8-BitLab/safestep/hardware/Week 4/Documents/SAFESTEP DESIGN DECISION_Week 4.pdf

### SAFESTEP DESIGN DECISION

### 1. Power

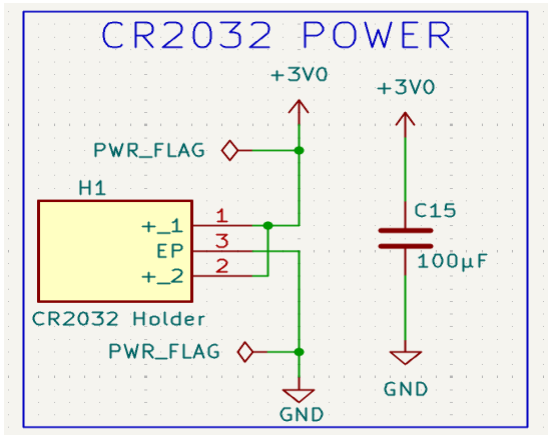
[picture p1: figure]

The device will be powered by CR2032 Battery. A CR2032 holder was added in the schematics.

CR2032 Battery: Nominal 3.0V (2.0v – 3.2v operating range), nominal capacity 220 -240mAh.

Battery Connection Flowchart
- CR2032 +
│
- 100μF (Bulk Decoupling Capacitor)

A 100 μF decoupling capacitor was added to act as a local energy tank that handles lowfrequency current spikes.

### 2. Reverse Protection

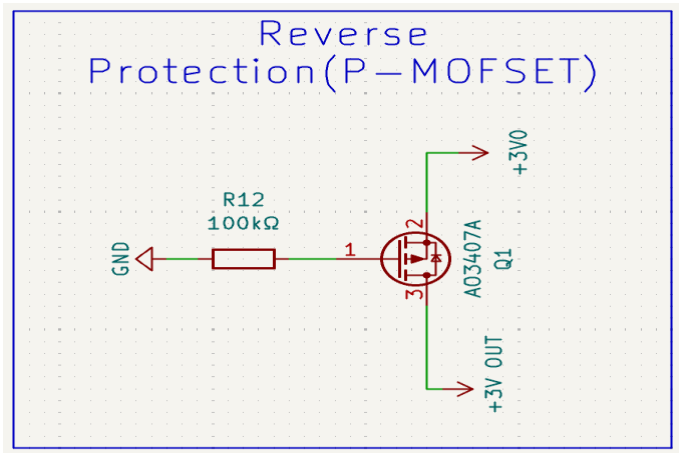
[picture p2: figure]

A P-MOFSET is used for reverse protection. The source is connected to the batteries positive terminal. The gate is pulled to ground via a 100k ohms resistor. The drain carried the output voltage.
The MOFSET of choice is AO3407A. The AO3407A uses advanced trench technology to provide excellent RDS (ON) with low gate charge. This device is suitable for use as a load switch or in PWM applications.
VDS | -30V
ID (at VGS=-10V) | -4.3A
RDS(ON) (at VGS=-10V) | < 48mW
RDS(ON) (at VGS =-4.5V) | < 78mW

3. ESP32 C3

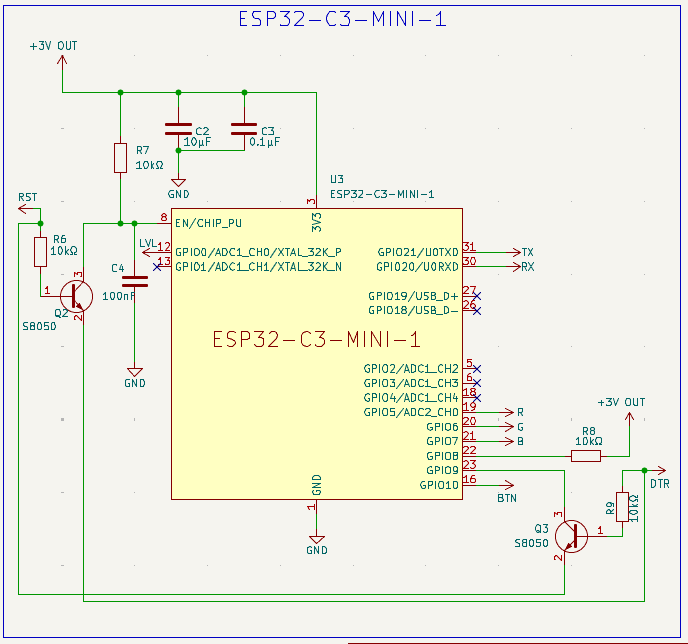
[picture p3: figure]

The ESP32-C3-MINI-1 is used as the MCU of choice for this project.

The power pin is supplied by the output from the MOSFET drain.

GPIO 8 is pulled high via a 10k ohms resistor to allow the MCU enter normal mode after reset.

Tx and Rx lines are connected to the UART pins.

The Enable pin is pulled high using a 10k ohms resistor and a 100nF capacitor pulled to the ground. An NPN transistor is connected to the same pin to allow for hard reset via UART pins.

The Boot pin is connected to an NPN transistor to allow for automatic state change via UART pins.

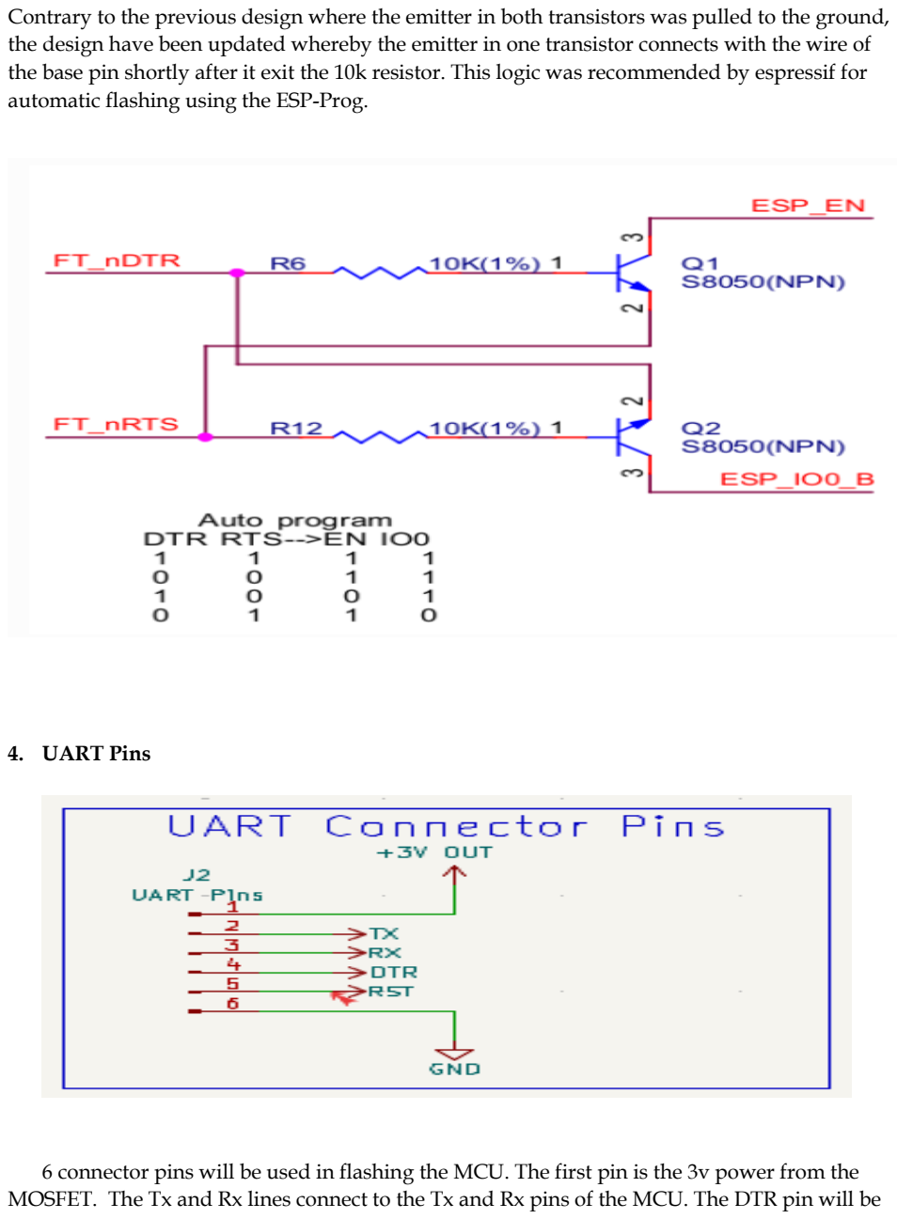
[picture p4: page 4]

Contrary to the previous design where the emitter in both transistors was pulled to the ground, the design have been updated whereby the emitter in one transistor connects with the wire of the base pin shortly after it exit the 10k resistor. This logic was recommended by espressif for automatic flashing using the ESP-Prog.

### 4. UART Pins

6 connector pins will be used in flashing the MCU. The first pin is the 3v power from the MOSFET. The Tx and Rx lines connect to the Tx and Rx pins of the MCU. The DTR pin will be used to automatically pull gpio9 Low, putting the MCU into download mode. The RST pin will automatically hard reset the MCU pin after flashing. The GND is connected to ground.

### 5. Battery Level

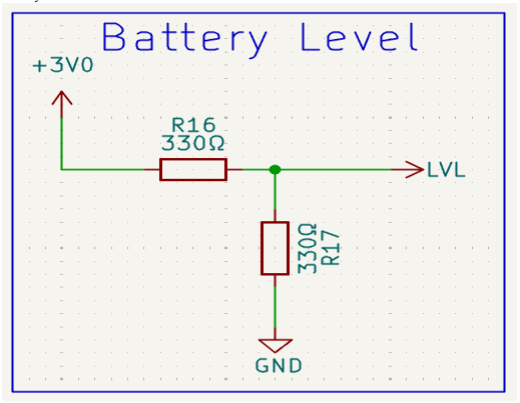
[picture p5: figure]

A battery capacity level monitoring was implemented using a voltage divider and ESP32 C3 ADC pin (gpio 0). This pin was tagged as LVL. The voltage divider serves to accurately divide the Input voltage (Battery 3v) and feed the voltage to the ADC where the voltage is converted to value. The Value can then be gotten through the firmware and multipled by 2 to get the correct voltage.
This logic was tested here and it turned out great: https://drive.google.com/file/d/1jga9iaDm6SIP6OQ40Vx7qFb9iOdV28Gf/view?usp=shar ing (https://drive.google.com/file/d/1jga9iaDm6SIP6OQ40Vx7qFb9iOdV28Gf/view?usp=sharing)

### 6. Button

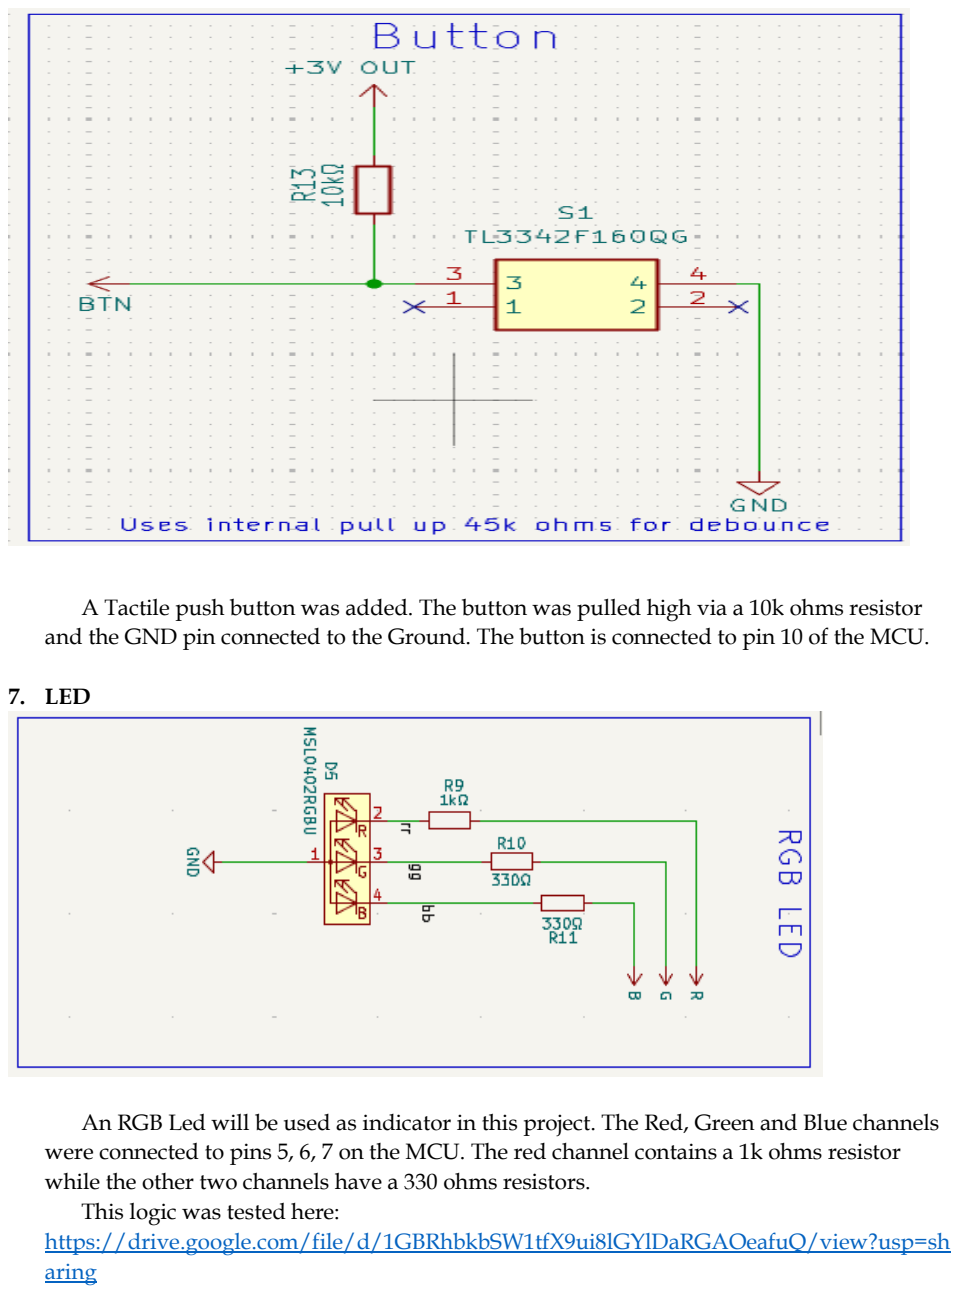
[picture p6: page 6]

A Tactile push button was added. The button was pulled high via a 10k ohms resistor and the GND pin connected to the Ground. The button is connected to pin 10 of the MCU.

### 7. LED

An RGB Led will be used as indicator in this project. The Red, Green and Blue channels were connected to pins 5, 6, 7 on the MCU. The red channel contains a 1k ohms resistor while the other two channels have a 330 ohms resistors.
This logic was tested here: https://drive.google.com/file/d/1GBRhbkbSW1tfX9ui8lGYlDaRGAOeafuQ/view?usp=sh aring (https://drive.google.com/file/d/1GBRhbkbSW1tfX9ui8lGYlDaRGAOeafuQ/view?usp=sharing)
