8-BitLab/safestep/hardware/Week 5/Documents/SAFESTEP DESIGN DECISION week 5.pdf

### SAFESTEP DESIGN DECISION

### 1. Power

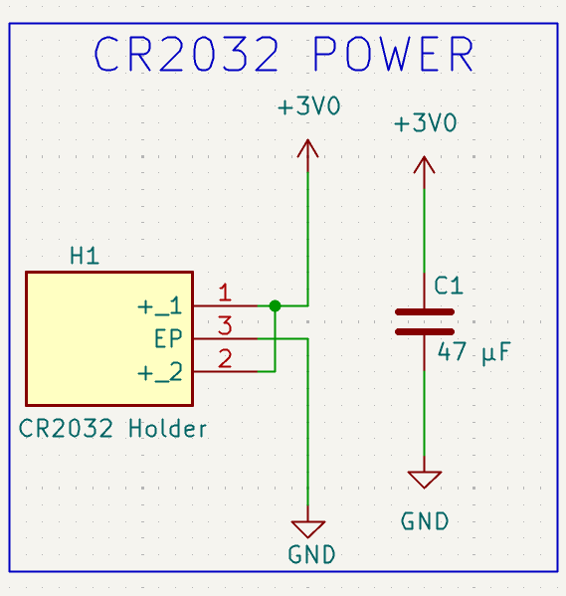
[picture p7: figure]

The device will be powered by CR2032 Battery. A CR2032 holder was added in the schematics.

CR2032 Battery: Nominal 3.0V (2.0v – 3.2v operating range), nominal capacity 220 -240mAh.

Battery Connection Flowchart
- CR2032 +

│
- 47μF (Bulk Decoupling Capacitor)

A 47 μF storage capacitor capacitor was added to act as a local energy tank that handles low-frequency current spikes.

### 2. Reverse Protection

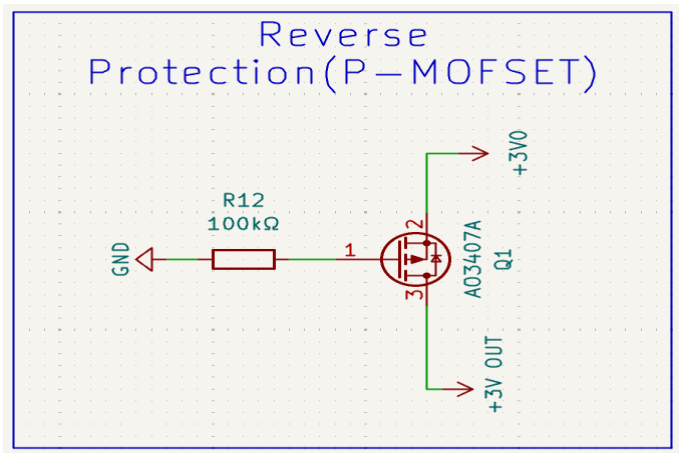
[picture p8: figure]

A P-MOFSET is used for reverse protection. The source is connected to the batteries positive terminal. The gate is pulled to ground via a 100k ohms resistor. The drain carried the output voltage.
The MOFSET of choice is AO3407A. The AO3407A uses advanced trench technology to provide excellent RDS (ON) with low gate charge. This device is suitable for use as a load switch or in PWM applications.
VDS | -30V
ID (at VGS=-10V) | -4.3A
RDS(ON) (at VGS=-10V) | < 48mW

RDS(ON) (at VGS =-4.5V) | < 78mW
3. ESP32 C3

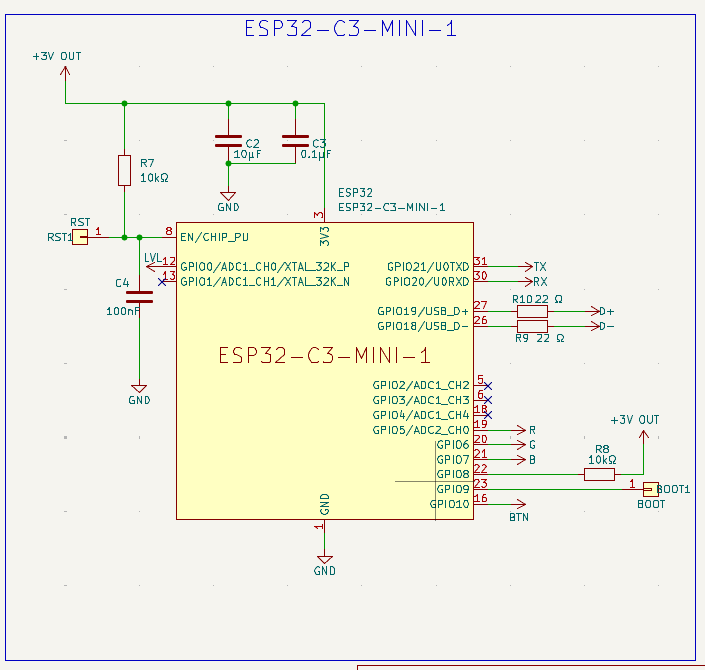
[picture p9: figure]

The ESP32-C3-MINI-1 is used as the MCU of choice for this project.

The power pin is supplied by the output from the MOSFET drain.

GPIO 8 is pulled high via a 10k ohms resistor to allow the MCU enter normal mode after reset.

Tx and Rx lines are connected to the UART pins.

The Enable pin is pulled high using a 10k ohms resistor and a 100nF capacitor pulled to the ground. A Test pad was added to CHIP_EN line to allow manual grounding (resetting) if the microcontroller locks up.

The Boot pin is connected to Test Pad If the USB controller becomes unresponsive due to a firmware crash or improper code, touch a ground wire to this pad to force the chip into download boot mode.

### 4. UART Pins

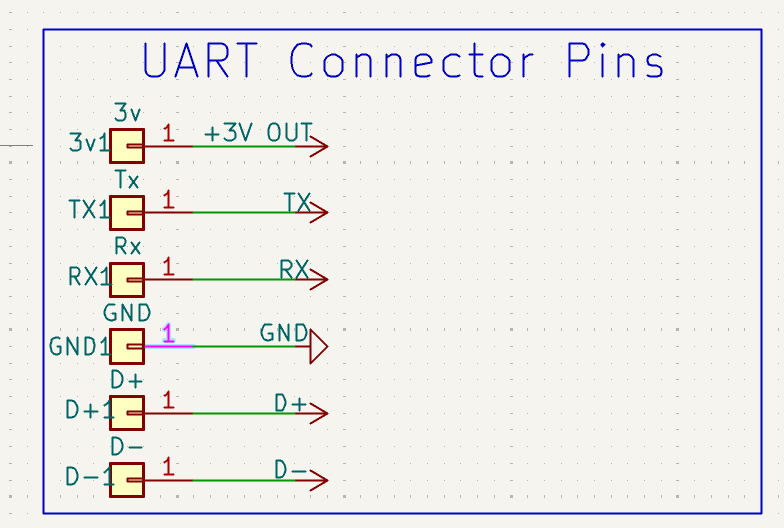
[picture p10: figure]

6 connector pins will be used in flashing the MCU. The first pin is the 3v power from the MOSFET. The Tx and Rx lines connect to the Tx and Rx pins of the MCU. The GND is connected to ground. The D+ and D- pins are for usb Data lines to be connected to the same pins in a USB C Breakout board.

### 5. Battery Level

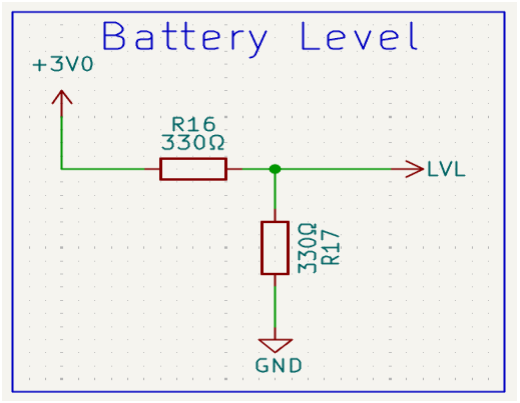
[picture p11: figure]

A battery capacity level monitoring was implemented using a voltage divider and ESP32 C3 ADC pin (gpio 0). This pin was tagged as LVL. The voltage divider serves to accurately divide the Input voltage (Battery 3v) and feed the voltage to the ADC where the voltage is converted to value. The Value can then be gotten through the firmware and multipled by 2 to get the correct voltage.
This logic was tested here and it turned out great: https://drive.google.com/file/d/1jga9iaDm6SIP6OQ40Vx7qFb9iOdV28Gf/view?usp=shar ing (https://drive.google.com/file/d/1jga9iaDm6SIP6OQ40Vx7qFb9iOdV28Gf/view?usp=sharing)

### 6. Button

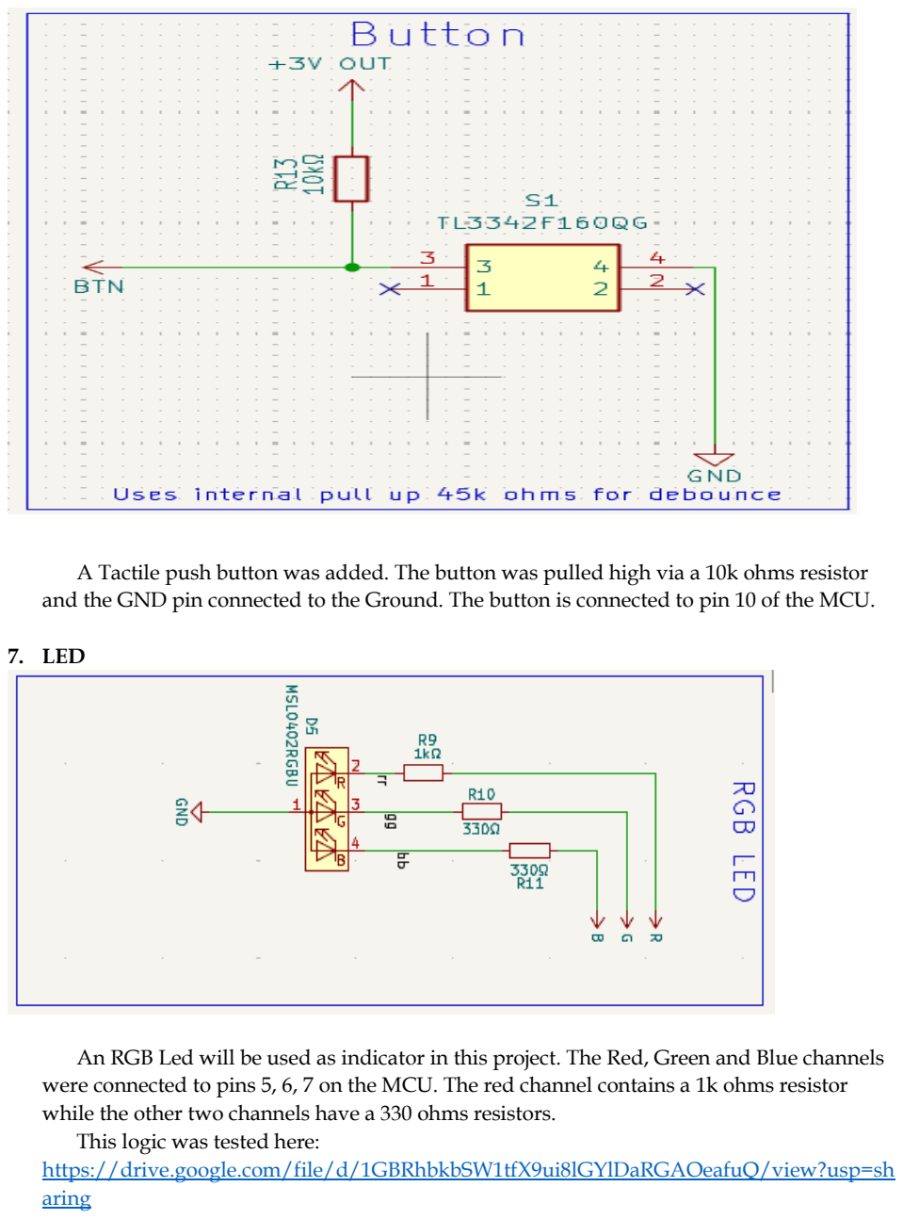
[picture p12: page 6]

A Tactile push button was added. The button was pulled high via a 10k ohms resistor and the GND pin connected to the Ground. The button is connected to pin 10 of the MCU.

### 7. LED

An RGB Led will be used as indicator in this project. The Red, Green and Blue channels were connected to pins 5, 6, 7 on the MCU. The red channel contains a 1k ohms resistor while the other two channels have a 330 ohms resistors.
This logic was tested here: https://drive.google.com/file/d/1GBRhbkbSW1tfX9ui8lGYlDaRGAOeafuQ/view?usp=sh aring (https://drive.google.com/file/d/1GBRhbkbSW1tfX9ui8lGYlDaRGAOeafuQ/view?usp=sharing)

TEST POINTS:

1. Boot: If the USB controller becomes unresponsive due to a firmware crash or improper code, you can manually touch a ground wire to this pad to force the chip into download boot mode.
2. Reset (RST) : connected to CHIP_EN line to allow manual grounding (resetting) if the microcontroller locks up.
