8-BitLab/safestep/hardware/Week 3/Documents/SAFESTEP DESIGN DECISION Week 3.pdf

### SAFESTEP DESIGN DECISION

### 1. Power


The device will be powered by CR2032 Battery. A CR2032 holder was added in the schematics.

CR2032 Battery: Nominal 3.0V (2.0v – 3.2v operating range), nominal capacity 220 -240mAh.

Battery Connection Flowchart
- CR2032 +
│
- 100μF (Bulk Decoupling Capacitor)

A 100 μF decoupling capacitor was added to act as a local energy tank that handles lowfrequency current spikes.

### 2. Reverse Protection


A P-MOFSET is used for reverse protection. The source is connected to the batteries positive terminal. The gate is pulled to ground via a 100k ohms resistor. The drain carried the output voltage.
The MOFSET of choice is AO3407A. The AO3407A uses advanced trench technology to provide excellent RDS(ON) with low gate charge. This device is suitable for use as a load switch or in PWM applications.
VDS | -30V
ID (at VGS=-10V) | -4.3A
RDS(ON) (at VGS=-10V) | < 48mW
RDS(ON) (at VGS =-4.5V) | < 78mW

3. ESP32 C3

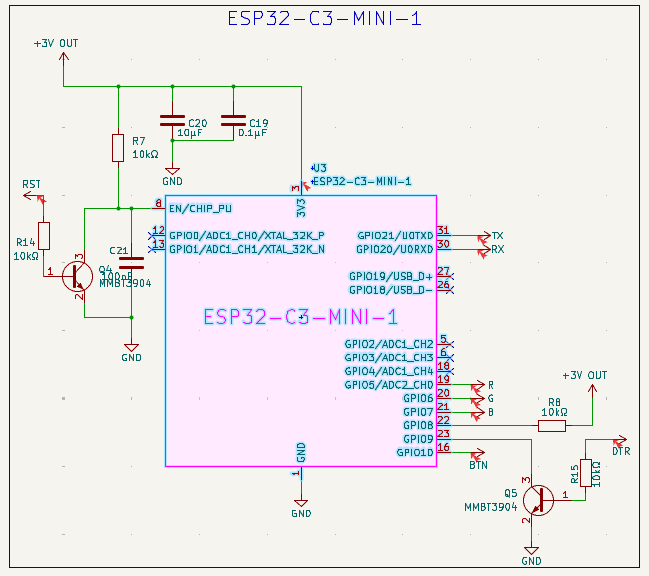
[picture p13: figure]

The ESP32-C3-MINI-1 is used as the MCU of choice for this project.

The power pin is supplied by the output from the MOSFET drain. T

he Enable pin is pulled high using a 10k ohms resistor and a 100nF capacitor pulled to the ground. An NPN transistor is connected to the same pin to allow for hard reset via UART pins.

The Boot pin is connected to an NPN transistor to allow for automatic state change via UART pins.

GPIO 8 is pulled high via a 10k ohms resistor to allow the MCU enter normal mode after reset.

Tx and Rx lines are connected to the UART pin

### 4. UART Pins

6 connector pins will be used in flashing the MCU. The first pin is the 3v power from the MOSFET. The Tx and Rx lines connect to the Tx and Rx pins of the MCU. The DTR pin will be used to automatically pull gpio9 Low, putting the MCU into download mode. The RST pin will automatically hard reset the MCU pin after flashing. The GND is connected to ground.

### 5. Button

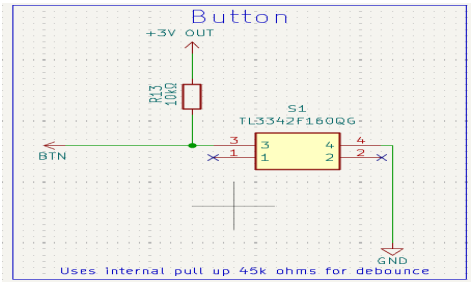
[picture p14: figure]

A Tactile push button was added. The button was pulled high via a 10k ohms resistor and the GND pin connected to the Ground. The button is connected to pin 10 of the MCU.

### 6. LED

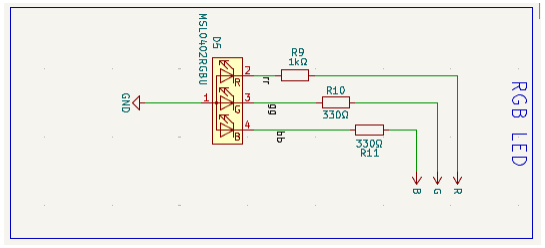
[picture p15: figure]

An RGB Led will be used as indicator in this project. The Red,Green and Blue channels were connected to pins 5, 6, 7 on the MCU . The red channel contains a 1k ohms resistor while the other two channels have a 330 ohms resistors.
