8-BitLab/safestep/hardware/Week 4/Research/COMPONENTS_v0.2.pdf

COMPONENTS

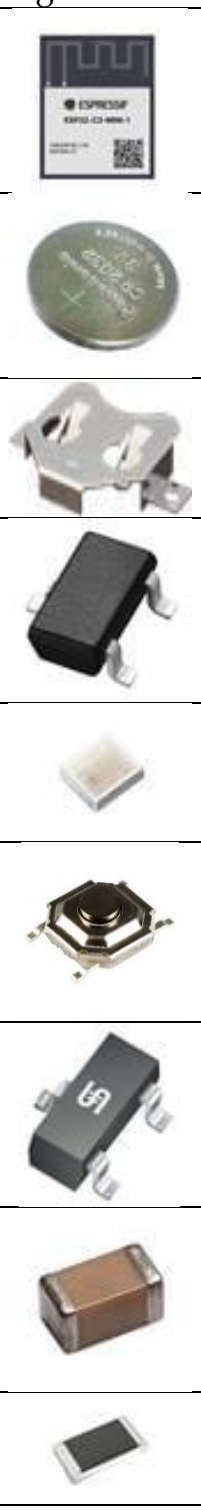
[picture p29: figure]

Image | Component | Type | Quantity | Price
| ESP32-C3-MINI-1 | MCU | 1 | 2.82 €
| CR2032 | Battery | 1 | 1.27 €
| BAT-HLD-003-SMT-TR | Battery Holder | 1 | 0.525 €
| AO3407A | P-MOSFET | 1 | 0.42 €
| MSL0402RGBU | RGB LED | 1 | 0.81 €
| TL3342F160QG/TR | BUTTON | 1 | 0.50 €
| S8050/SS8050 | NPN Transistor | 2 | 0.249 €
| 0402 Ceramic Capacitor | Capacitor | 10 | 2.27 €
| 0402 Thin Film Resistors | Resistors | 10 | 1.45 €
TOTAL | | | | 10.341 €
