8-BitLab/safestep/hardware/Week 7/Documents/Safestep esp32_c3_mini_1 Schematics v0.6.pdf

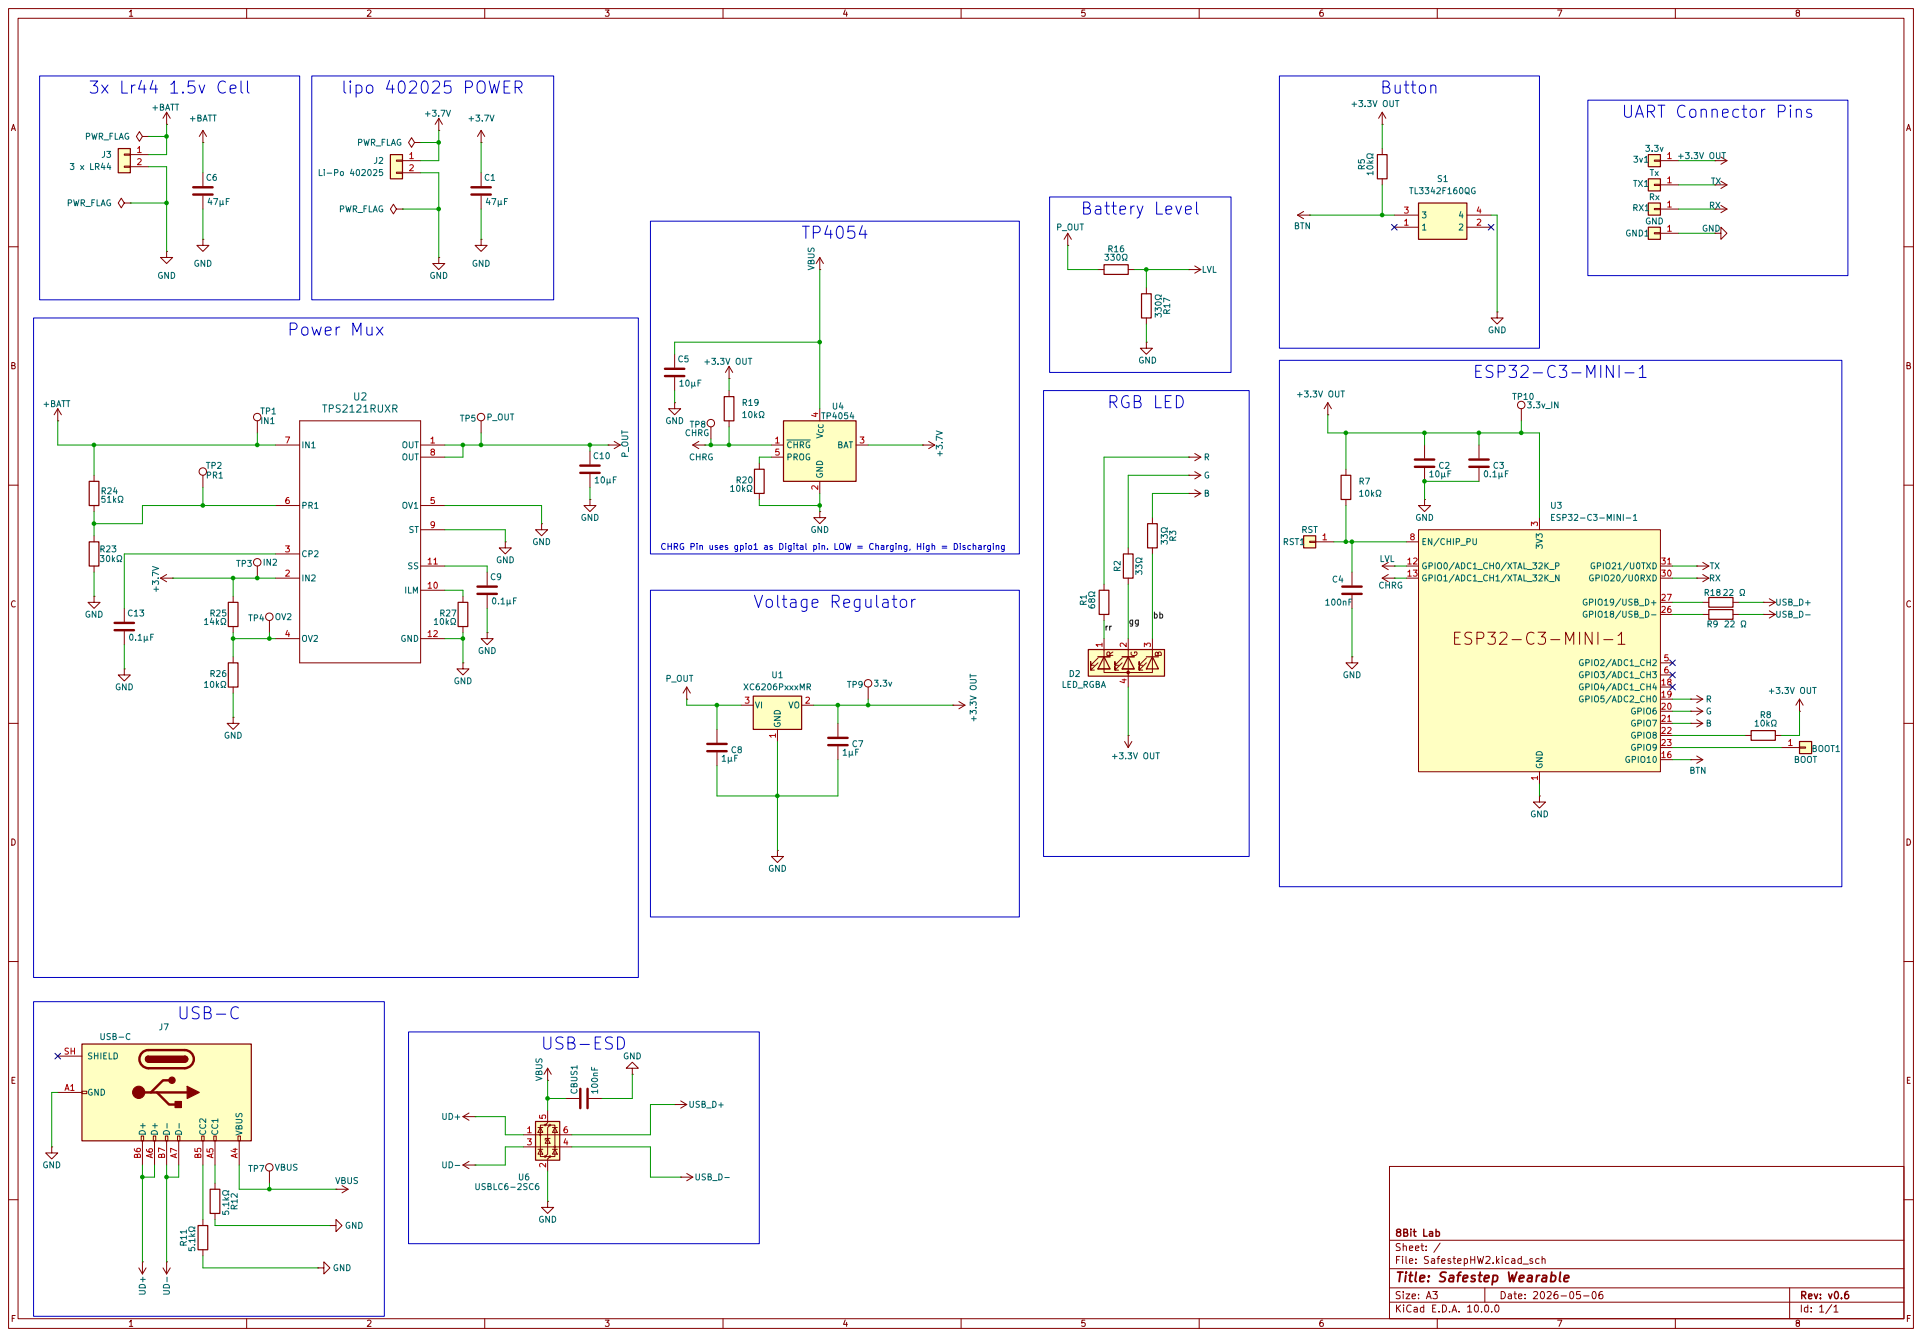
[picture p32: page 1]
