8-BitLab/safestep/hardware/Week 5/Documents/Safestep esp32_c3_mini_1 Schematics v0.5.pdf

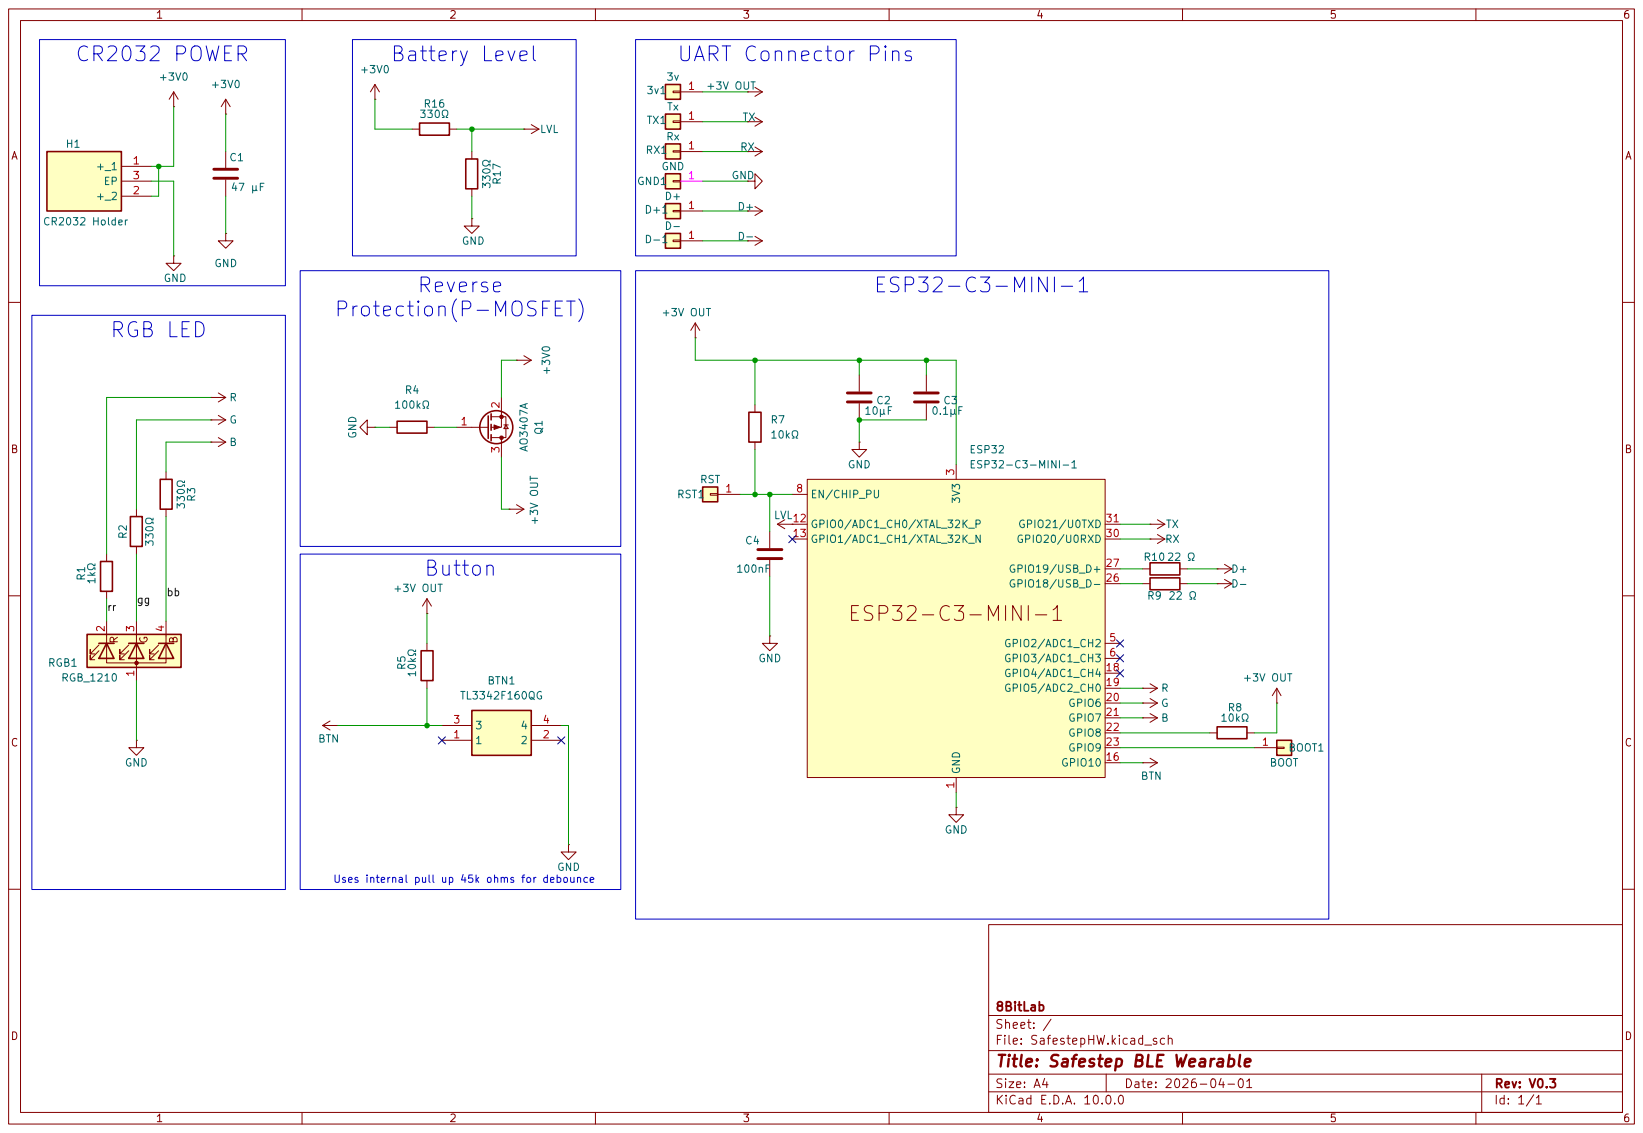
[picture p33: page 1]
