8-BitLab/safestep/hardware/Week 3/Documents/Safestep esp32_c3_mini_1 Schematics v0.3.pdf

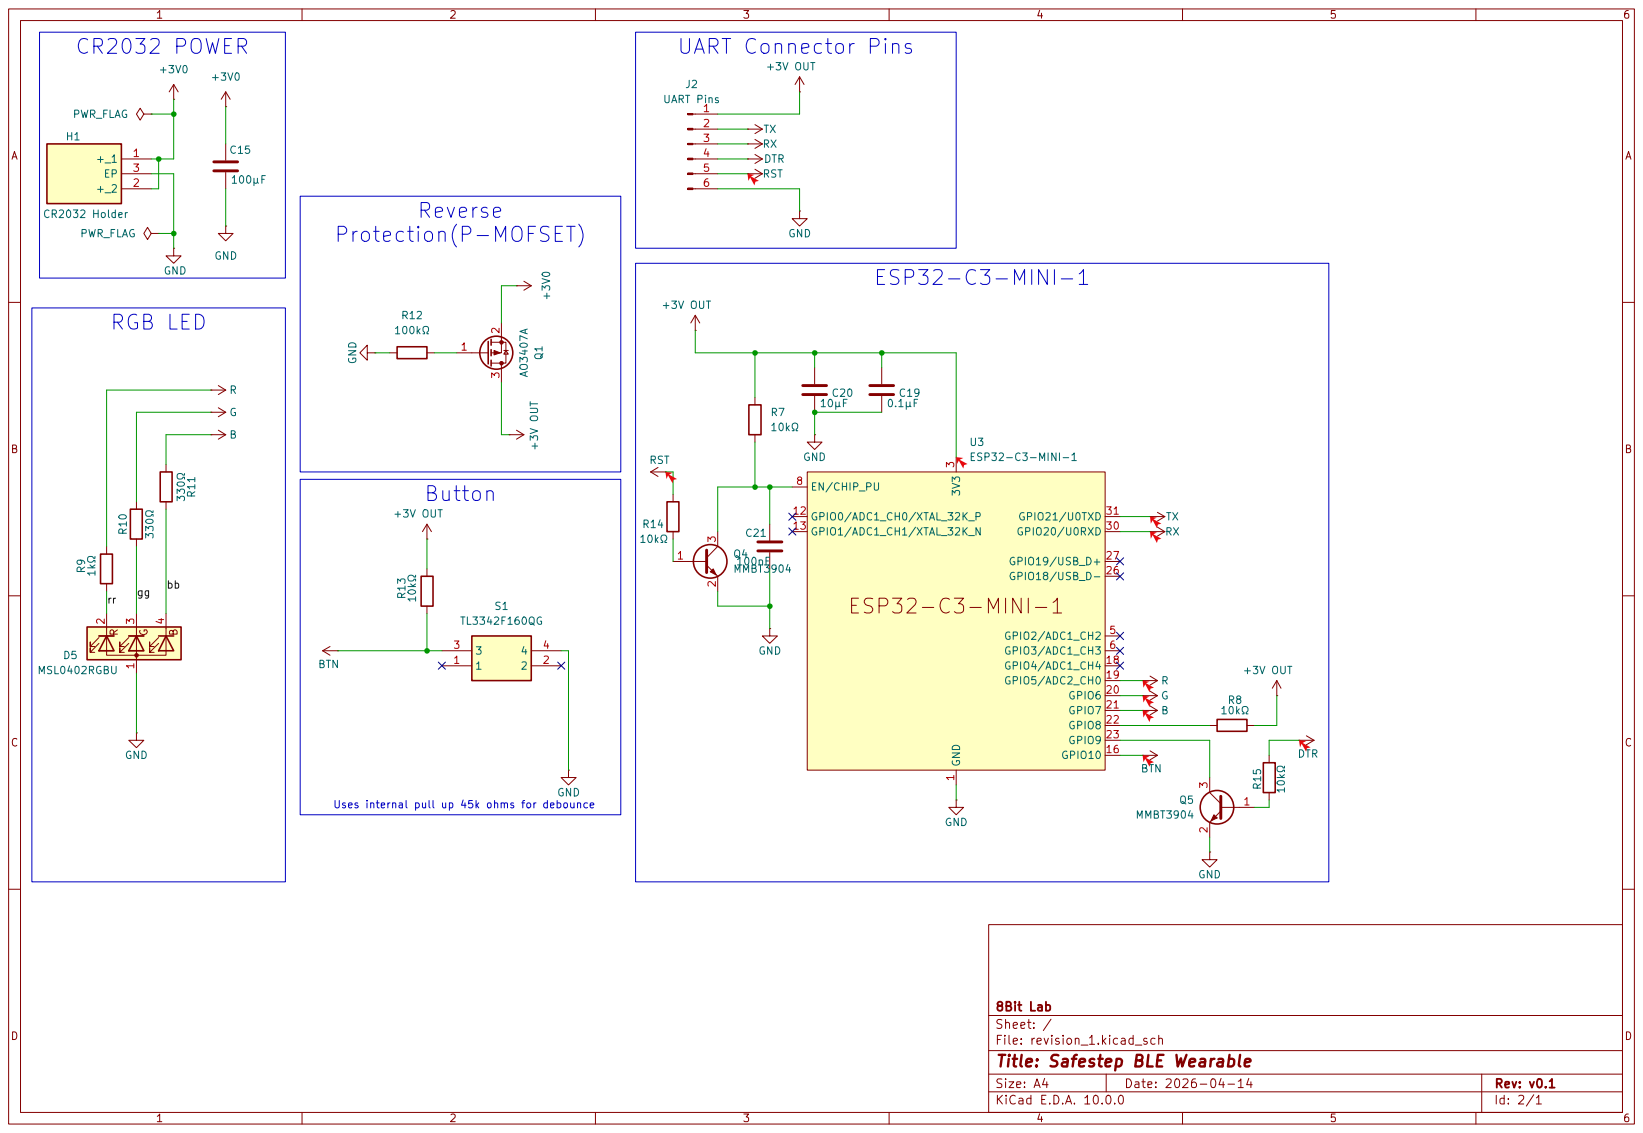
[picture p34: page 1]
