8-BitLab/safestep/hardware/Week 7/PCB/SafestepHW2.kicad_pcb

## KiCad design hardware/Week 7/PCB/SafestepHW2.kicad_pcb (2026-05-11)

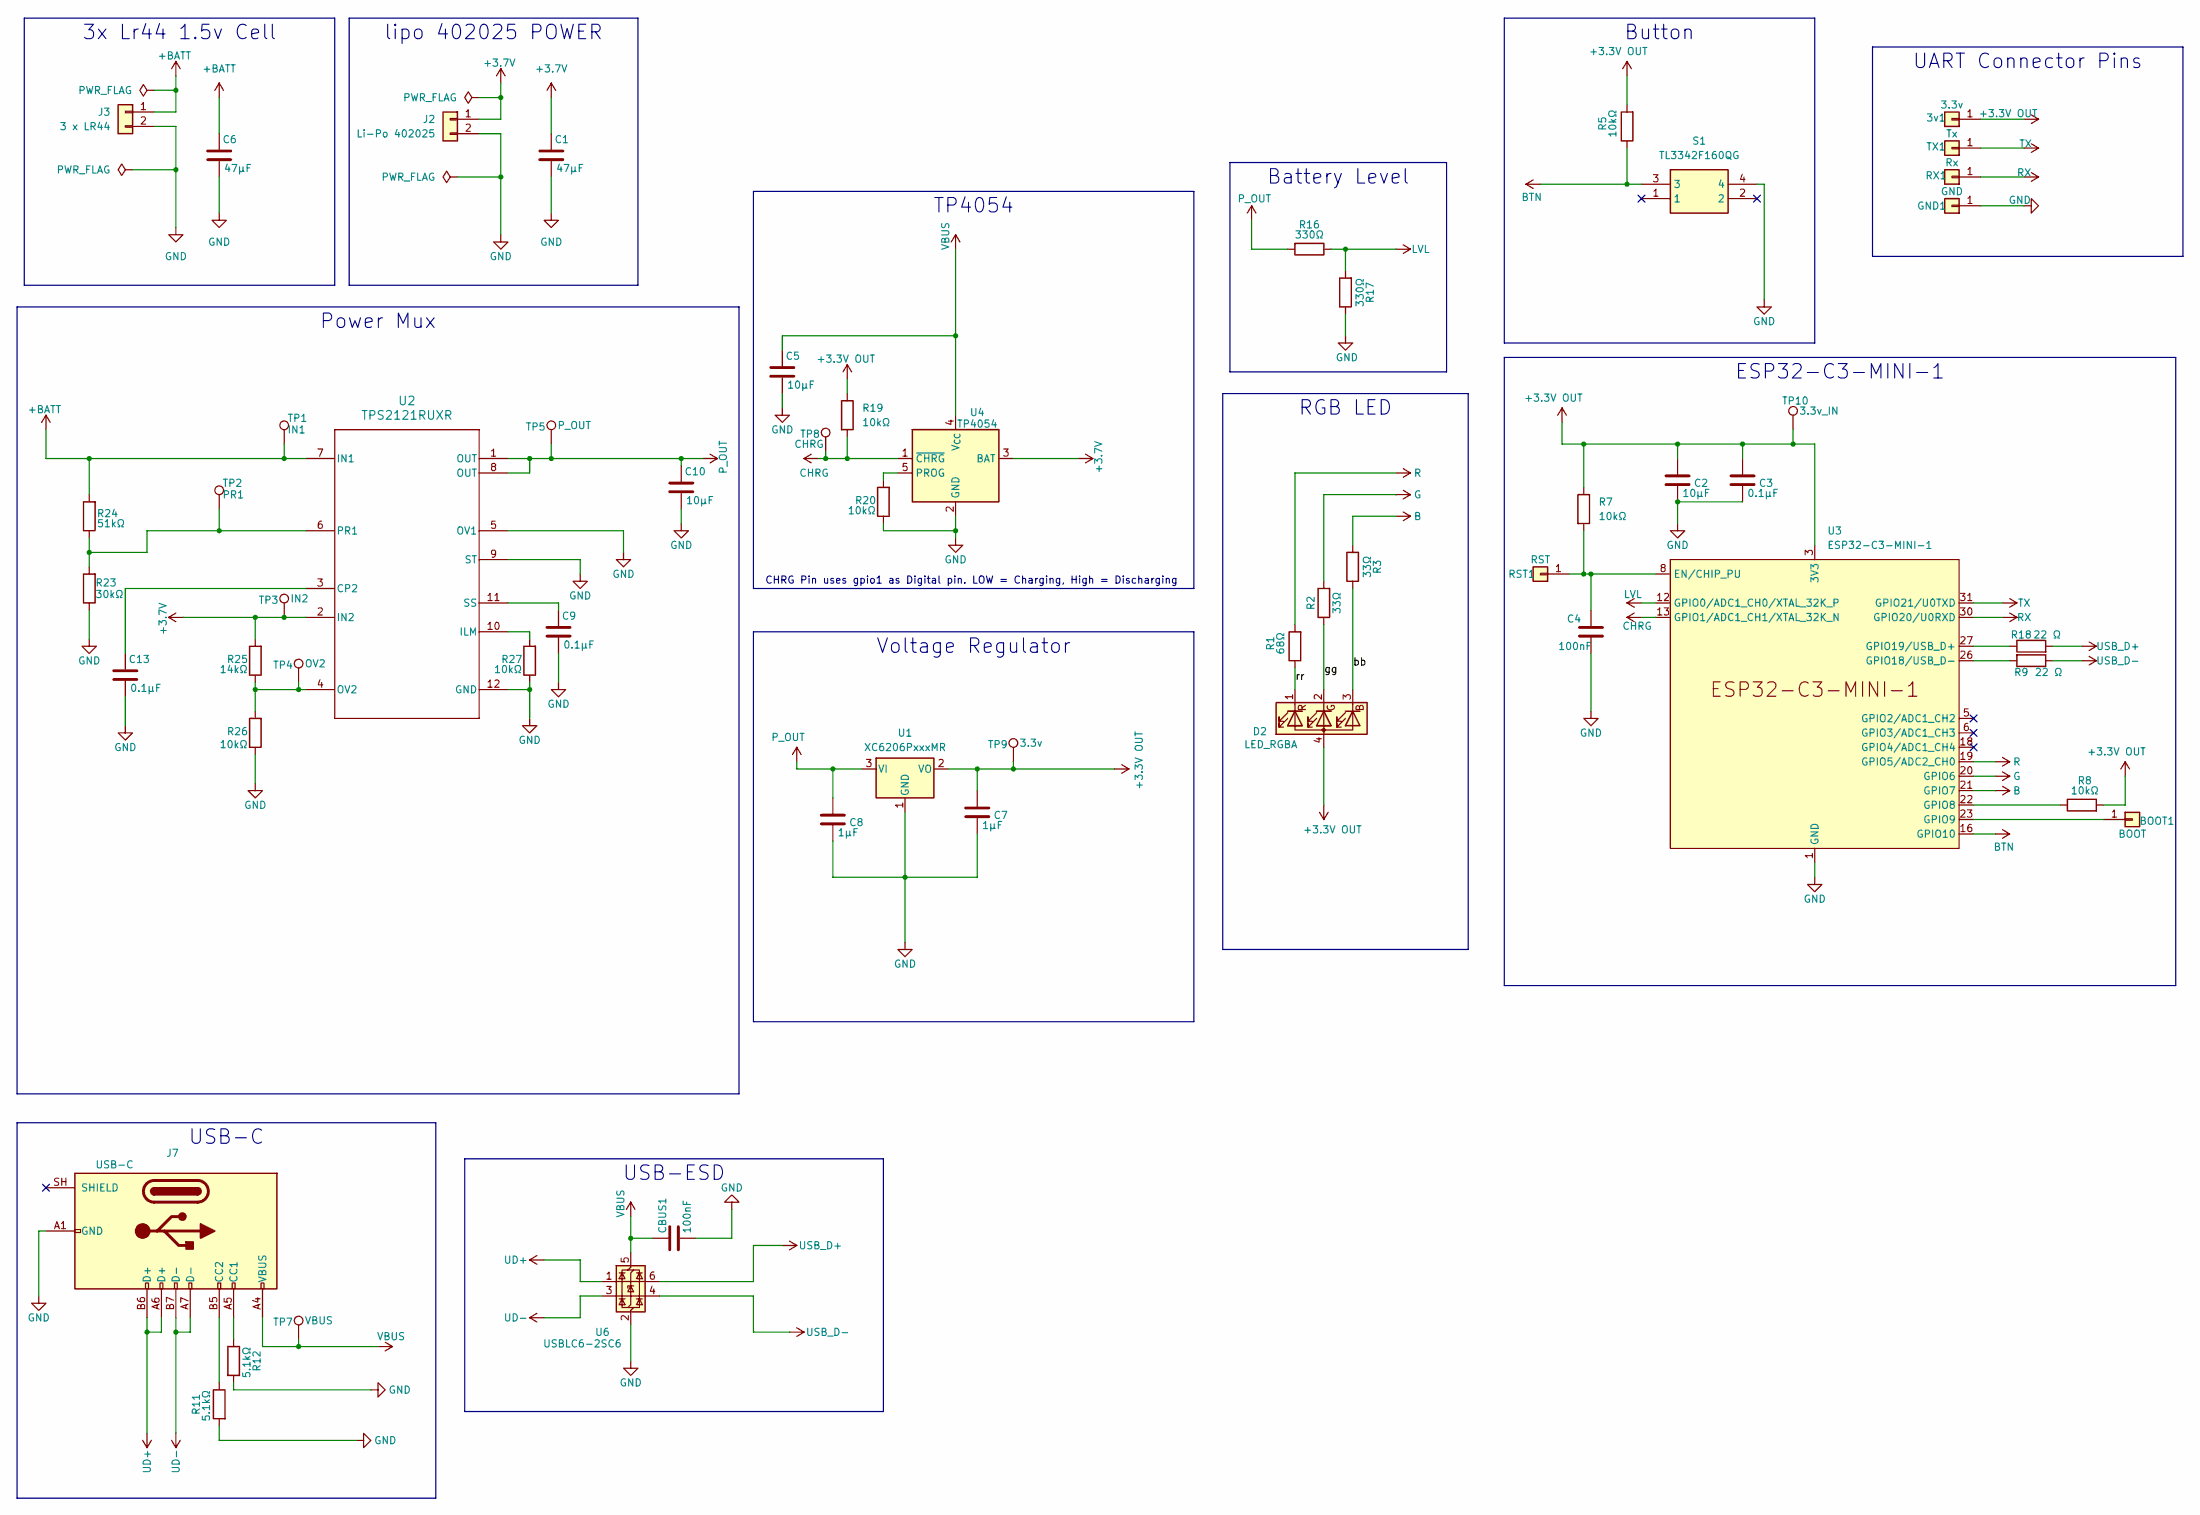
[picture p35: schematic SafestepHW2.kicad_sch, Safestep Wearable]

Parts:
3v1: 3.3v; TestPoint_THTPad_2.0x2.0mm_Drill1.0mm
BOOT1: BOOT; TestPoint_Pad_2.0x2.0mm
C1, C6: 47µF; CP_EIA-1608-08_AVX-J; Manufacturer_Part_Number TAJB476K010RNJ
C2: 10μF; C_0201_0603Metric; Manufacturer_Part_Number GRM188R61A106ME69D
C3: 0.1μF; C_0201_0603Metric; Manufacturer_Part_Number GRM033R61A104KE15D
C4: 100nF; C_0201_0603Metric; Manufacturer_Part_Number GRM033R61A104KE15D
C5, C10: 10µF; C_0201_0603Metric; Manufacturer_Part_Number GRM188R61A106ME69D
C7: 1μF; C_0201_0603Metric; Manufacturer_Part_Number GRM188R61A106ME69D
C8: 1μF; C_0201_0603Metric; Manufacturer_Part_Number GRM033R61A104KE15D
C9, C13: 0.1µF; C_0201_0603Metric; Manufacturer_Part_Number GRM188R61A106ME69D
CBUS1: 100nF; C_0201_0603Metric; Manufacturer_Part_Number GRM033R61A104KE15D
D2: LED_RGBA; LED_RGB_1210; Manufacturer_Part_Number IN-S128TATRGB
GND1: GND; TestPoint_THTPad_2.0x2.0mm_Drill1.0mm
J2: Li-Po 402025; JST_PH_S2B-PH-K_1x02_P2.00mm_Horizontal; Manufacturer_Part_Number S2B-PH-K-S
J3: 3 x LR44; JST_PH_S2B-PH-K_1x02_P2.00mm_Horizontal; Manufacturer_Part_Number S2B-PH-K-S
J7: USB-C; USB_C_Receptacle_HRO_TYPE-C-31-M-12; Manufacturer_Part_Number USB4105-GF-A
R1: 68Ω; R_0201_0603Metric; Manufacturer_Part_Number RC0201FR-0768RL
R2, R3: 33Ω; R_0201_0603Metric; Manufacturer_Part_Number RC0201FR-0733RL
R5, R7, R8, R19, R20, R26, R27: 10kΩ; R_0201_0603Metric; Manufacturer_Part_Number RC0603FR-0710KL
R9, R18: 22 Ω; R_0201_0603Metric; Manufacturer_Part_Number RC0201FR-0722RL
R11, R12: 5.1kΩ; R_0201_0603Metric; Manufacturer_Part_Number RC0603FR-075K1L
R16, R17: 330Ω; R_0201_0603Metric; Manufacturer_Part_Number RC0603FR-07330RL
R23: 30kΩ; R_0201_0603Metric; Manufacturer_Part_Number RC0603FR-0710KL
R24: 51kΩ; R_0201_0603Metric; Manufacturer_Part_Number RC0603FR-0710KL
R25: 14kΩ; R_0201_0603Metric; Manufacturer_Part_Number RC0603FR-0710KL
RST1: RST; TestPoint_Pad_2.0x2.0mm
RX1: Rx; TestPoint_THTPad_2.0x2.0mm_Drill1.0mm
S1: TL3342F160QG; Mouser Part Number 612-TL3342F160
TP1: IN1; TestPoint_Pad_D1.0mm
TP2: PR1; TestPoint_Pad_D1.0mm
TP3: IN2; TestPoint_Pad_D1.0mm
TP4: OV2; TestPoint_Pad_D1.0mm
TP5: P_OUT; TestPoint_Pad_D1.0mm
TP7: VBUS; TestPoint_Pad_D1.0mm
TP8: CHRG; TestPoint_Pad_D1.0mm
TP9: 3.3v; TestPoint_Pad_D1.0mm
TP10: 3.3v_IN; TestPoint_Pad_D1.0mm
TX1: Tx; TestPoint_THTPad_2.0x2.0mm_Drill1.0mm
U1: XC6206PxxxMR; SOT-23-3
U2: TPS2121RUXR; RUX0012A
U3: ESP32-C3-MINI-1; Manufacturer_Part_Number ESP32-C3-MINI-1-N4X
U4: TP4054; TSOT-23-5; Manufacturer_Part_Number LTC4054ES5-4.2#TRMPBF
U6: USBLC6-2SC6; SOT-23-6; Manufacturer_Part_Number USBLC6-2SC6

Connections:
+3.3V OUT: 3v1.1 (Pin_1_1), C2.1, C3.1, C7.1, D2.4 (A), R5.2, R7.1, R8.2, R19.1, TP9.1 (1_1), TP10.1 (1_1), U1.2 (VO), U3.3 (3V3)
+3.7V: C1.1, J2.1, R25.2, TP3.1 (1_1), U2.2 (IN2), U4.3 (BAT)
+BATT: C6.1, J3.1, R24.2, TP1.1 (1_1), U2.7 (IN1)
/bb: D2.3 (BK), R3.1
/gg: D2.2 (GK), R2.1
/rr: D2.1 (RK), R1.1
B: R3.2, U3.21 (GPIO7)
BTN: R5.1, S1.3, U3.16 (GPIO10)
CHRG: R19.2, TP8.1 (1_1), U3.13 (GPIO1/ADC1_CH1/XTAL_32K_N), U4.1 (~CHRG)
G: R2.2, U3.20 (GPIO6)
GND: C1.2, C2.2, C3.2, C4.2, C5.2, C6.2, C7.2, C8.2, C9.2, C10.2, C13.2, CBUS1.2, GND1.1 (Pin_1_1), J2.2, J3.2, J7.A1 (GND), J7.A12 (GND), J7.B1 (GND), J7.B12 (GND), R11.2, R12.2, R17.1, R20.1, R23.1, R26.1, R27.1, S1.4, U1.1 (GND), U2.5 (OV1), U2.9 (ST), U2.12 (GND), U3.1 (GND), U3.2 (GND), U3.11 (GND), U3.14 (GND), U3.36 (GND), U3.37 (GND), U3.38 (GND), U3.39 (GND), U3.40 (GND), U3.41 (GND), U3.42 (GND), U3.43 (GND), U3.44 (GND), U3.45 (GND), U3.46 (GND), U3.47 (GND), U3.48 (GND), U3.49 (GND), U3.50 (GND), U3.51 (GND), U3.52 (GND), U3.53 (GND), U4.2 (GND), U6.2 (GND)
LVL: R16.1, R17.2, U3.12 (GPIO0/ADC1_CH0/XTAL_32K_P)
unnamed: BOOT1.1 (Pin_1_1), U3.23 (GPIO9)
unnamed: J7.A5 (CC1), R12.1
unnamed: J7.B5 (CC2), R11.1
unnamed: C4.1, R7.2, RST1.1 (Pin_1_1), U3.8 (EN/CHIP_PU)
unnamed: C13.1, U2.3 (CP2)
unnamed: R27.2, U2.10 (ILM)
unnamed: R25.1, R26.2, TP4.1 (1_1), U2.4 (OV2)
unnamed: R23.2, R24.1, TP2.1 (1_1), U2.6 (PR1)
unnamed: C9.1, U2.11 (SS)
unnamed: R8.1, U3.22 (GPIO8)
unnamed: R9.2, U3.26 (GPIO18/USB_D-)
unnamed: R18.1, U3.27 (GPIO19/USB_D+)
unnamed: R20.2, U4.5 (PROG)
P_OUT: C8.1, C10.1, R16.2, TP5.1 (1_1), U1.3 (VI), U2.1 (OUT), U2.8 (OUT)
R: R1.2, U3.19 (GPIO5/ADC2_CH0)
RX: RX1.1 (Pin_1_1), U3.30 (GPIO20/U0RXD)
TX: TX1.1 (Pin_1_1), U3.31 (GPIO21/U0TXD)
UD+: J7.A6 (D+), J7.B6 (D+), U6.1 (I/O1)
UD-: J7.A7 (D-), J7.B7 (D-), U6.3 (I/O2)
USB_D+: R18.2, U6.6 (I/O1)
USB_D-: R9.1, U6.4 (I/O2)
VBUS: C5.1, CBUS1.1, J7.A4 (VBUS), J7.A9 (VBUS), J7.B4 (VBUS), J7.B9 (VBUS), TP7.1 (1_1), U4.4 (V_{CC}), U6.5 (VBUS)

Notes on the sheet:
CHRG Pin uses gpio1 as Digital pin. LOW = Charging, High = Discharging
TP4054
UART Connector Pins
Power Mux
RGB LED
ESP32-C3-MINI-1
Button
lipo 402025 POWER
Voltage Regulator
USB-ESD
USB-C
3x Lr44 1.5v Cell
Battery Level

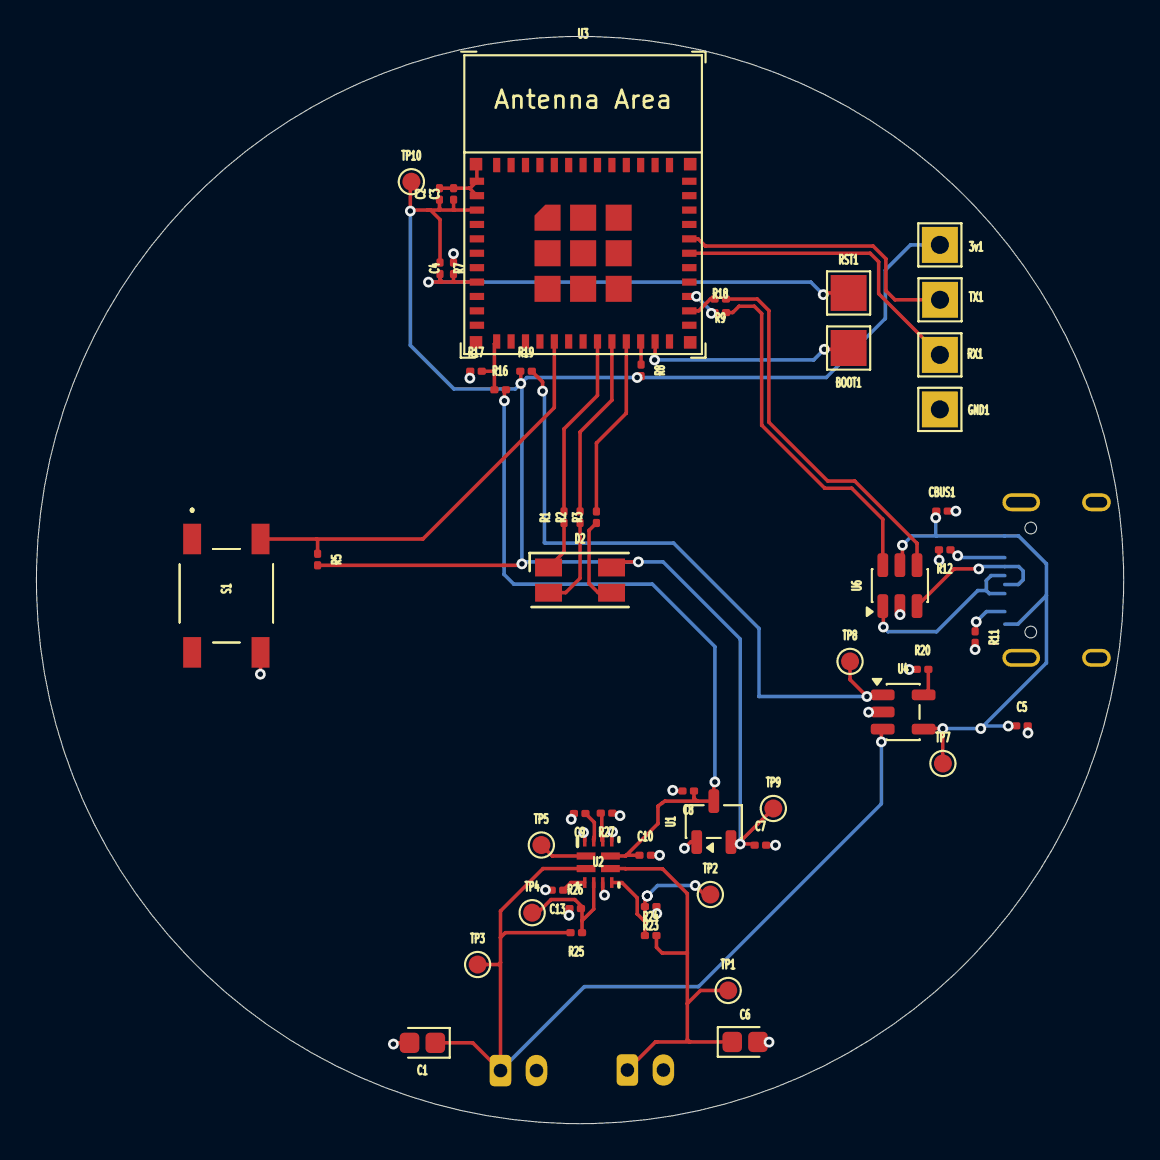
[picture p36: board SafestepHW2.kicad_pcb from above]

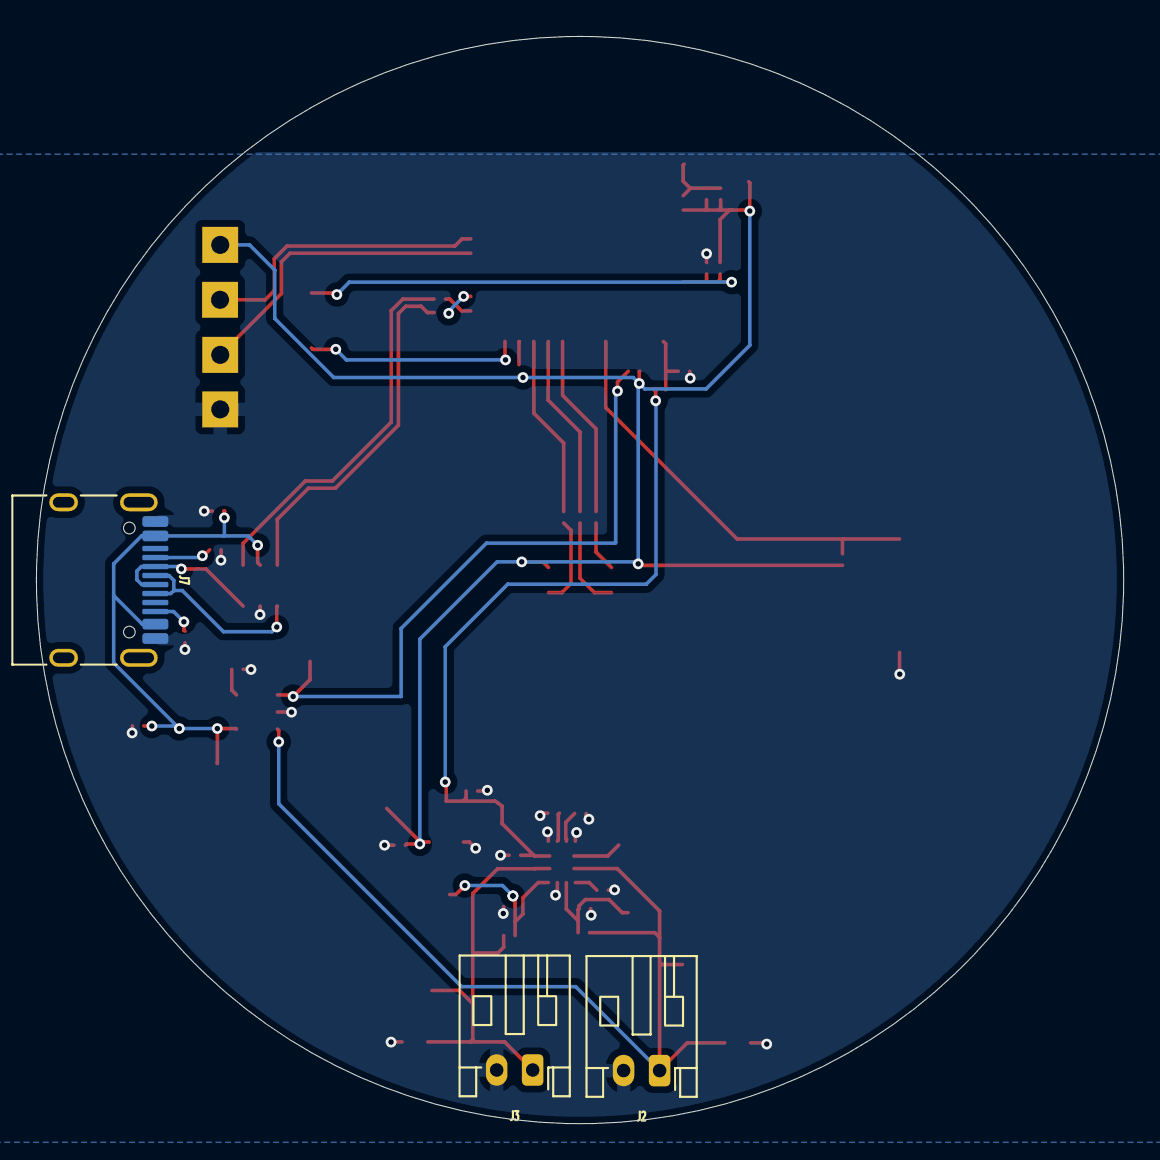
[picture p37: board SafestepHW2.kicad_pcb from below]

Board: 2 copper layers, 60.4 x 60.4 mm, 56 parts (3 on the bottom side), 34 nets.
