8-BitLab/safestep/hardware/Week 4/PCB/SafestepHW.kicad_pcb

## KiCad design hardware/Week 4/PCB/SafestepHW.kicad_pcb (2026-05-02)

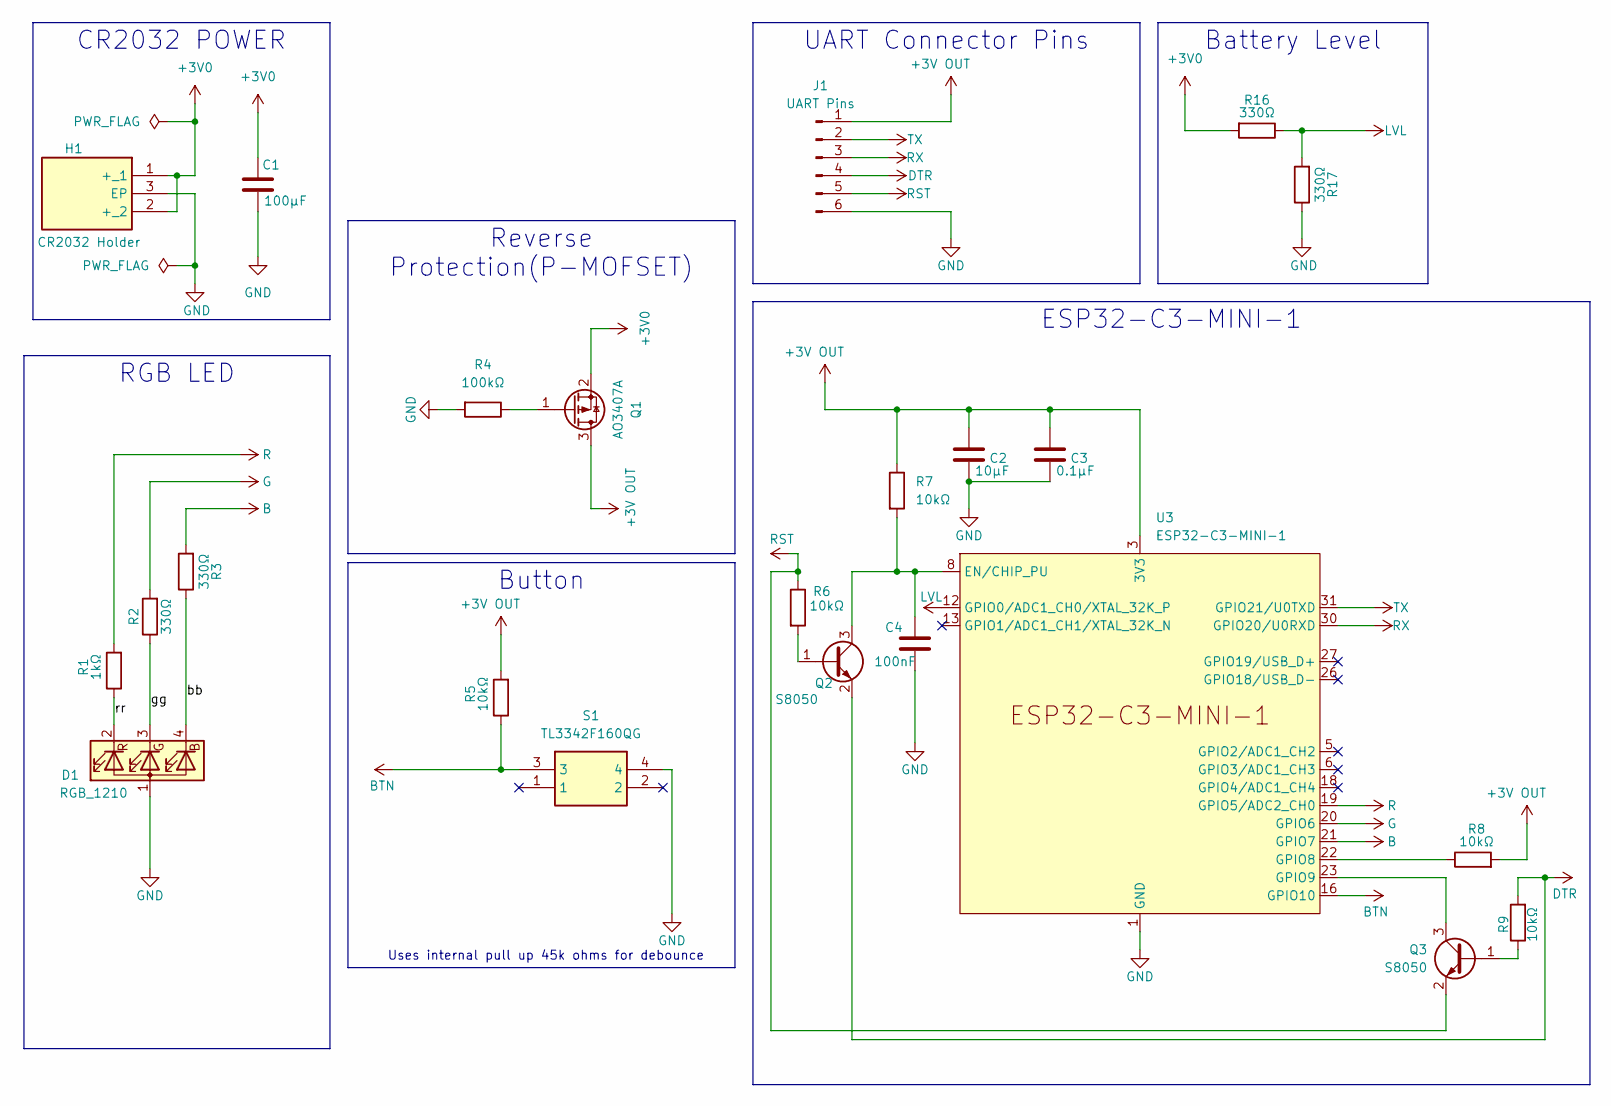
[picture p38: schematic SafestepHW.kicad_sch, Safestep BLE Wearable]

Parts:
C1: 100µF; C_01005_0402Metric
C2: 10μF; C_01005_0402Metric
C3: 0.1μF; C_01005_0402Metric
C4: 100nF; C_01005_0402Metric
D1: RGB_1210; LED_RGB_1210
H1: CR2032 Holder; BATHLD003SMT; Mouser Part Number 712-BAT-HLD-003-SMT
J1: UART Pins; PinHeader_1x06_P2.54mm_Vertical
Q1: AO3407A; SOT-23
Q2, Q3: S8050; SOT-23
R1: 1kΩ; R_01005_0402Metric
R2, R3, R16, R17: 330Ω; R_01005_0402Metric
R4: 100kΩ; R_01005_0402Metric
R5, R6, R7, R8, R9: 10kΩ; R_01005_0402Metric
S1: TL3342F160QG; Mouser Part Number 612-TL3342F160
U3: ESP32-C3-MINI-1

Connections:
+3V0: C1.1, H1.1 (+_1), H1.2 (+_2), Q1.2 (S), R16.2
+3V OUT: C2.1, C3.1, J1.1, Q1.3 (D), R5.2, R7.1, R8.2, U3.3 (3V3)
/bb: D1.4 (BK), R3.1
/gg: D1.3 (GK), R2.1
/rr: D1.2 (RK), R1.1
B: R3.2, U3.21 (GPIO7)
BTN: R5.1, S1.3, U3.16 (GPIO10)
DTR: J1.4, Q2.2 (E), R9.2
G: R2.2, U3.20 (GPIO6)
GND: C1.2, C2.2, C3.2, C4.2, D1.1 (A), H1.3 (EP), J1.6, R4.2, R17.1, S1.4, U3.1 (GND), U3.2 (GND), U3.11 (GND), U3.14 (GND), U3.36 (GND), U3.37 (GND), U3.38 (GND), U3.39 (GND), U3.40 (GND), U3.41 (GND), U3.42 (GND), U3.43 (GND), U3.44 (GND), U3.45 (GND), U3.46 (GND), U3.47 (GND), U3.48 (GND), U3.49 (GND), U3.50 (GND), U3.51 (GND), U3.52 (GND), U3.53 (GND)
LVL: R16.1, R17.2, U3.12 (GPIO0/ADC1_CH0/XTAL_32K_P)
unnamed: Q1.1 (G), R4.1
unnamed: Q2.1 (B), R6.2
unnamed: C4.1, Q2.3 (C), R7.2, U3.8 (EN/CHIP_PU)
unnamed: Q3.1 (B), R9.1
unnamed: Q3.3 (C), U3.23 (GPIO9)
unnamed: R8.1, U3.22 (GPIO8)
R: R1.2, U3.19 (GPIO5/ADC2_CH0)
RST: J1.5, Q3.2 (E), R6.1
RX: J1.3, U3.30 (GPIO20/U0RXD)
TX: J1.2, U3.31 (GPIO21/U0TXD)

Notes on the sheet:
Uses internal pull up 45k ohms for debounce
ESP32-C3-MINI-1
CR2032 POWER
Button
UART Connector Pins
Reverse Protection(P-MOFSET)
Battery Level
RGB LED

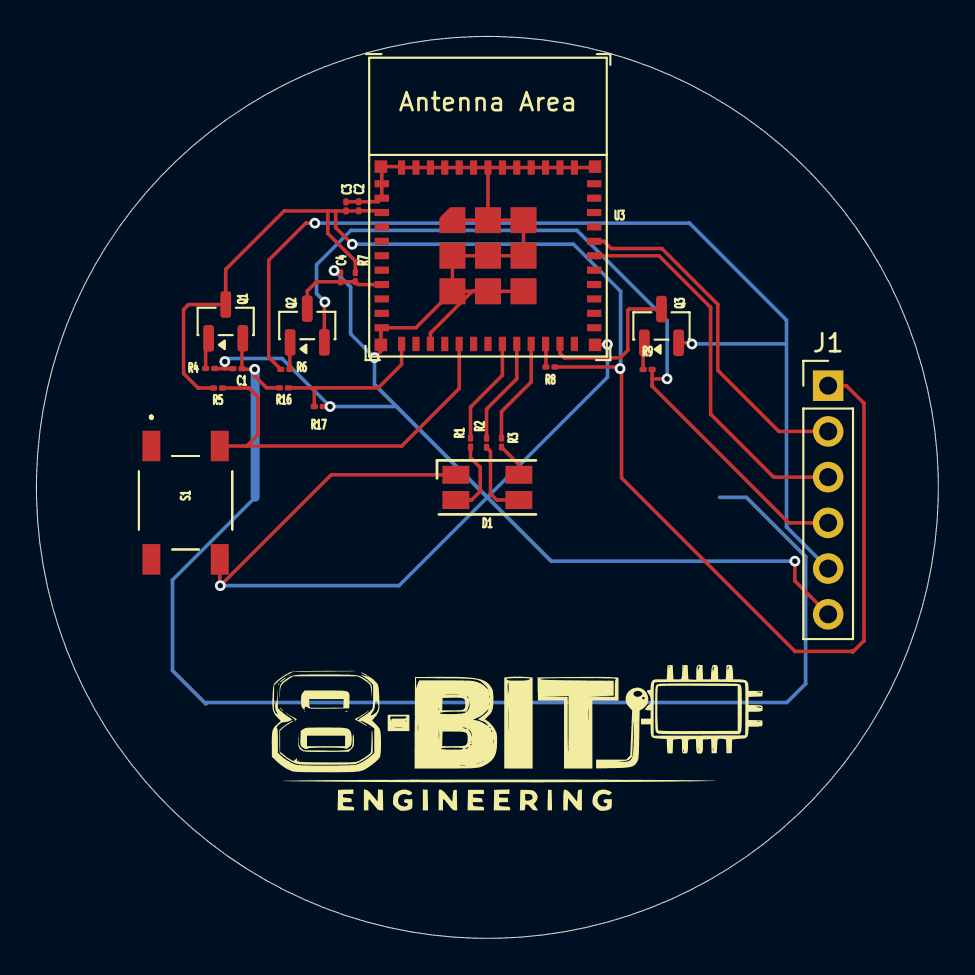
[picture p39: board hardware/Week 4/PCB/SafestepHW.kicad_pcb from above]

Board: 2 copper layers, 50.1 x 50.1 mm, 23 parts (1 on the bottom side), 21 nets.
