8-BitLab/safestep/hardware/Week 5/PCB/SafestepHW.kicad_pcb

## KiCad design hardware/Week 5/PCB/SafestepHW.kicad_pcb (2026-05-02)

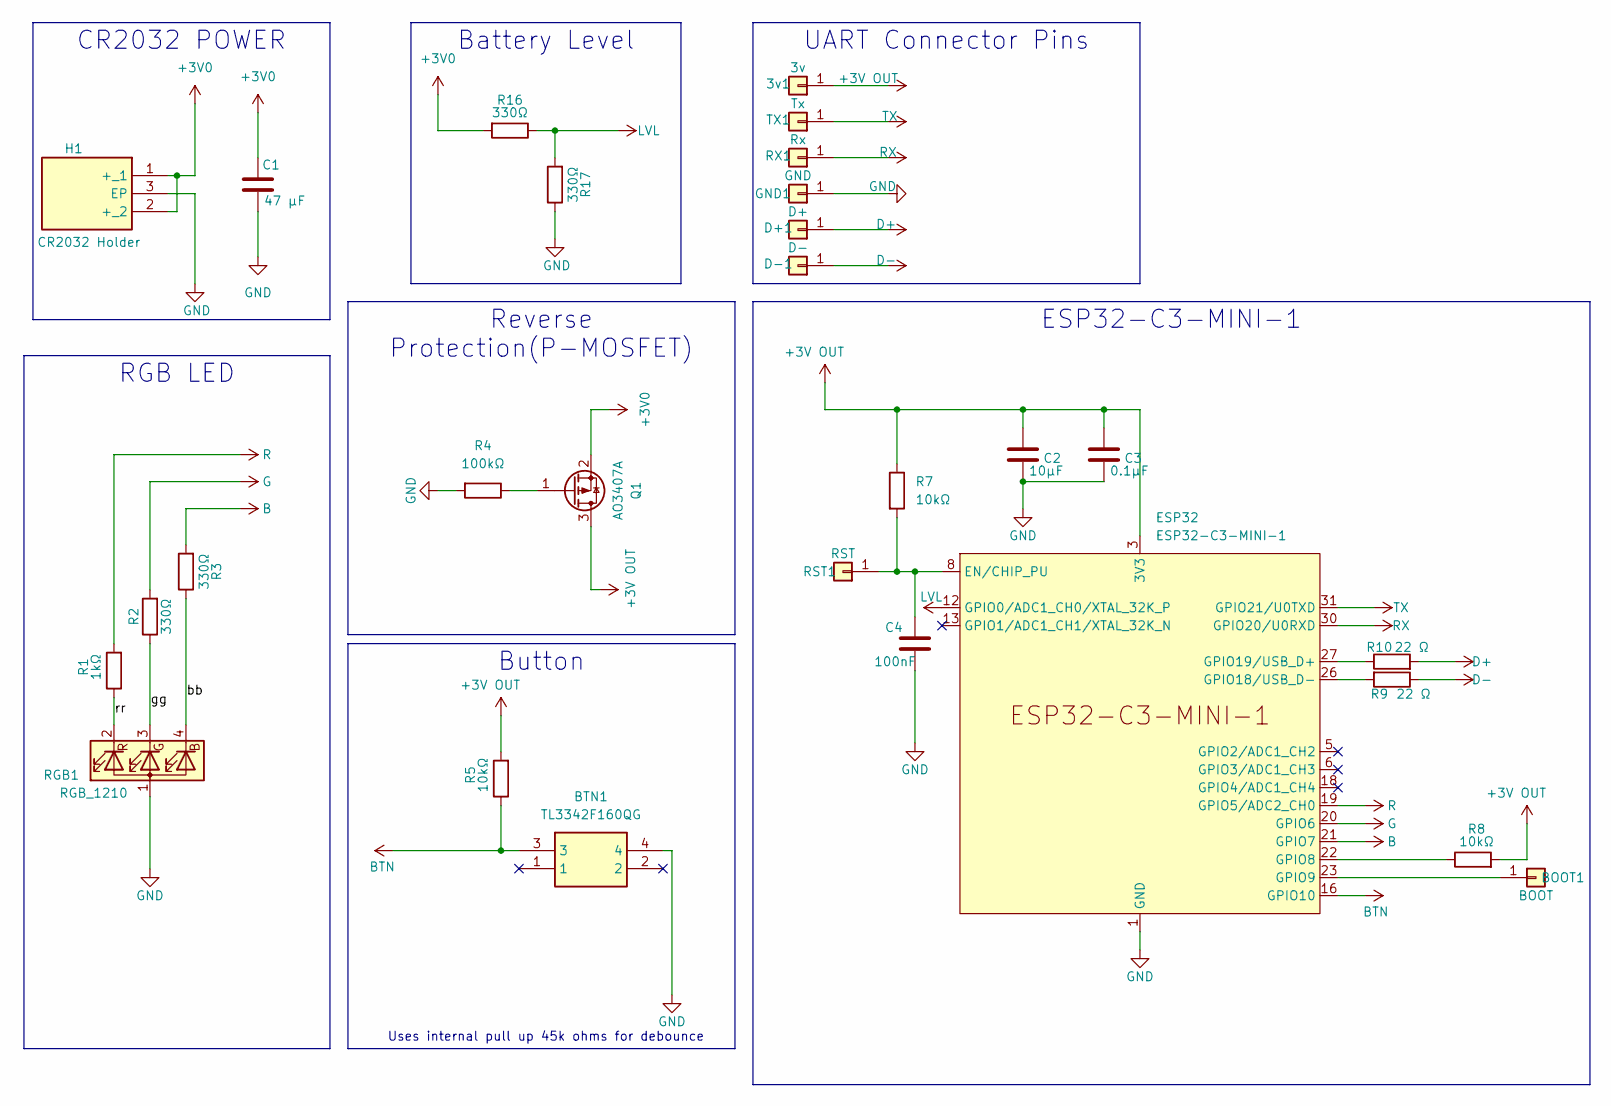
[picture p40: schematic SafestepHW.kicad_sch, Safestep BLE Wearable]

Parts:
3v1: 3v; TestPoint_THTPad_2.0x2.0mm_Drill1.0mm
BOOT1: BOOT; TestPoint_Pad_2.0x2.0mm
BTN1: TL3342F160QG; Mouser Part Number 612-TL3342F160
C1: 47 µF; C_01005_0402Metric
C2: 10μF; C_01005_0402Metric
C3: 0.1μF; C_01005_0402Metric
C4: 100nF; C_01005_0402Metric
D+1: D+; TestPoint_THTPad_2.0x2.0mm_Drill1.0mm
D-1: D-; TestPoint_THTPad_2.0x2.0mm_Drill1.0mm
ESP32: ESP32-C3-MINI-1
GND1: GND; TestPoint_THTPad_2.0x2.0mm_Drill1.0mm
H1: CR2032 Holder; BATHLD003SMT; Mouser Part Number 712-BAT-HLD-003-SMT
Q1: AO3407A; SOT-23
R1: 1kΩ; R_01005_0402Metric
R2, R3, R16, R17: 330Ω; R_01005_0402Metric
R4: 100kΩ; R_01005_0402Metric
R5, R7, R8: 10kΩ; R_01005_0402Metric
R9, R10: 22 Ω; R_01005_0402Metric
RGB1: RGB_1210; LED_RGB_1210
RST1: RST; TestPoint_Pad_2.0x2.0mm
RX1: Rx; TestPoint_THTPad_2.0x2.0mm_Drill1.0mm
TX1: Tx; TestPoint_THTPad_2.0x2.0mm_Drill1.0mm

Connections:
+3V0: C1.1, H1.1 (+_1), H1.2 (+_2), Q1.2 (S), R16.2
+3V OUT: 3v1.1 (Pin_1_1), C2.1, C3.1, ESP32.3 (3V3), Q1.3 (D), R5.2, R7.1, R8.2
/bb: R3.1, RGB1.4 (BK)
/gg: R2.1, RGB1.3 (GK)
/rr: R1.1, RGB1.2 (RK)
B: ESP32.21 (GPIO7), R3.2
BTN: BTN1.3, ESP32.16 (GPIO10), R5.1
D+: D+1.1 (Pin_1_1), R10.2
D-: D-1.1 (Pin_1_1), R9.1
G: ESP32.20 (GPIO6), R2.2
GND: BTN1.4, C1.2, C2.2, C3.2, C4.2, ESP32.1 (GND), ESP32.2 (GND), ESP32.11 (GND), ESP32.14 (GND), ESP32.36 (GND), ESP32.37 (GND), ESP32.38 (GND), ESP32.39 (GND), ESP32.40 (GND), ESP32.41 (GND), ESP32.42 (GND), ESP32.43 (GND), ESP32.44 (GND), ESP32.45 (GND), ESP32.46 (GND), ESP32.47 (GND), ESP32.48 (GND), ESP32.49 (GND), ESP32.50 (GND), ESP32.51 (GND), ESP32.52 (GND), ESP32.53 (GND), GND1.1 (Pin_1_1), H1.3 (EP), R4.2, R17.1, RGB1.1 (A)
LVL: ESP32.12 (GPIO0/ADC1_CH0/XTAL_32K_P), R16.1, R17.2
unnamed: BOOT1.1 (Pin_1_1), ESP32.23 (GPIO9)
unnamed: C4.1, ESP32.8 (EN/CHIP_PU), R7.2, RST1.1 (Pin_1_1)
unnamed: ESP32.22 (GPIO8), R8.1
unnamed: ESP32.26 (GPIO18/USB_D-), R9.2
unnamed: ESP32.27 (GPIO19/USB_D+), R10.1
unnamed: Q1.1 (G), R4.1
R: ESP32.19 (GPIO5/ADC2_CH0), R1.2
RX: ESP32.30 (GPIO20/U0RXD), RX1.1 (Pin_1_1)
TX: ESP32.31 (GPIO21/U0TXD), TX1.1 (Pin_1_1)

Notes on the sheet:
Uses internal pull up 45k ohms for debounce
ESP32-C3-MINI-1
CR2032 POWER
UART Connector Pins
Button
Reverse Protection(P-MOSFET)
Battery Level
RGB LED

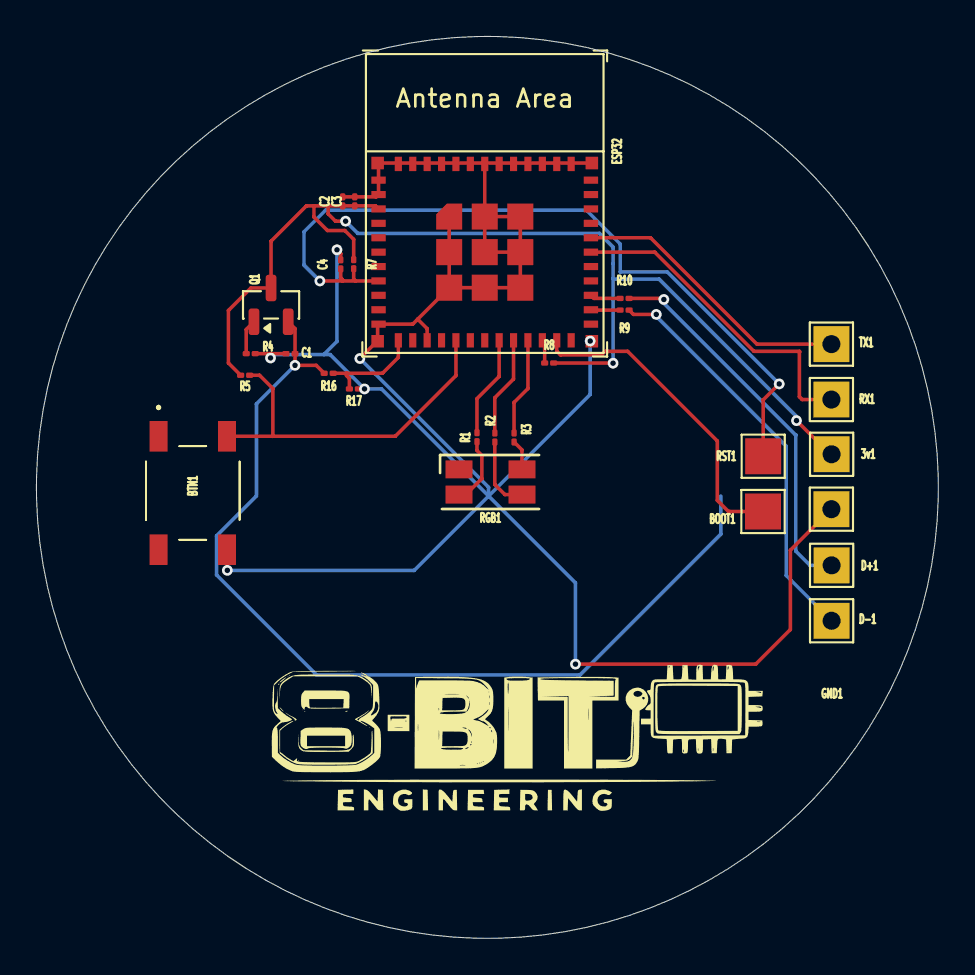
[picture p41: board hardware/Week 5/PCB/SafestepHW.kicad_pcb from above]

Board: 2 copper layers, 50.1 x 50.1 mm, 28 parts (1 on the bottom side), 21 nets.
