8-BitLab/safestep/hardware/Week 2/Schematics/Schematics_v0.2.kicad_sch

## KiCad design hardware/Week 2/Schematics/Schematics_v0.2.kicad_sch (2026-04-20)

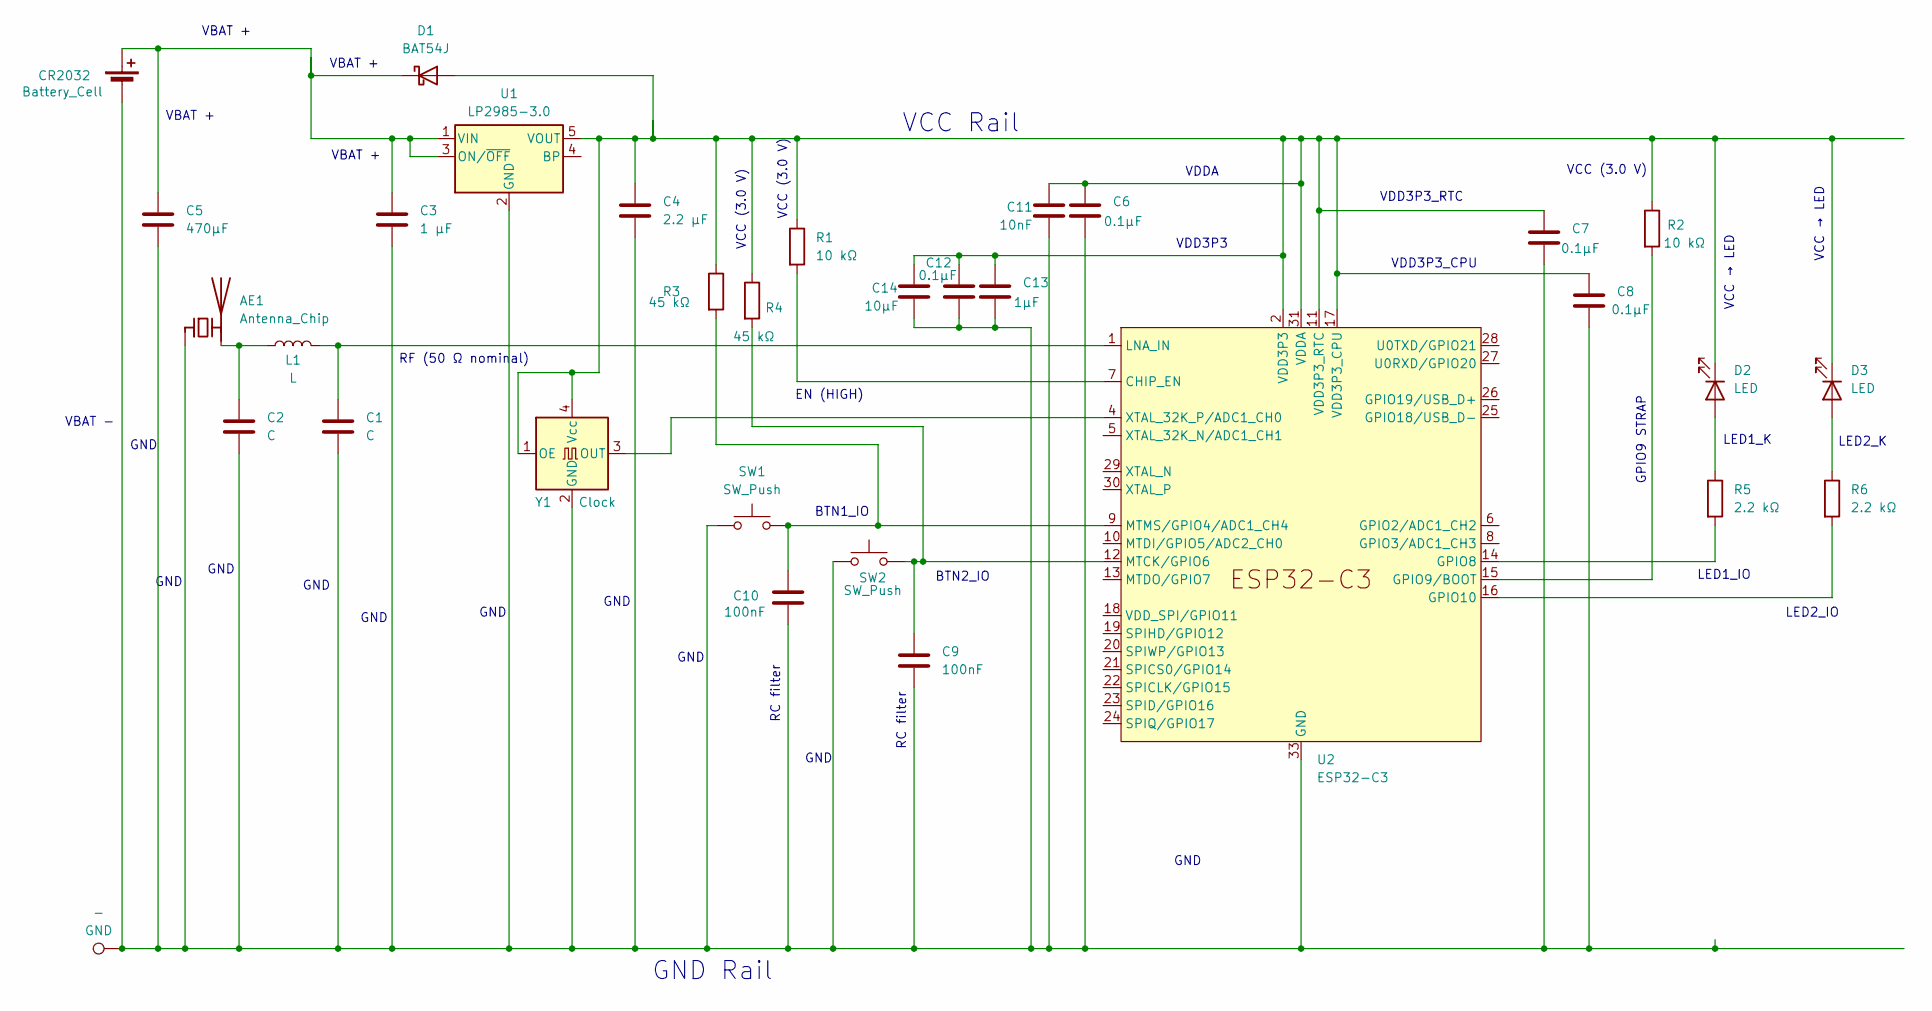
[picture p42: schematic Schematics_v0.2.kicad_sch]

Parts:
-: GND
AE1: Antenna_Chip
C1, C2: C
C3: 1 μF
C4: 2.2 μF
C5: 470µF
C6, C7, C8, C12: 0.1µF
C9, C10: 100nF
C11: 10nF
C13: 1µF
C14: 10µF
CR2032: Battery_Cell
D1: BAT54J; D_SOD-323F
D2, D3: LED
L1: L
R1, R2: 10 kΩ
R3, R4: 45 kΩ
R5, R6: 2.2 kΩ
SW1, SW2: SW_Push
U1: LP2985-3.0; SOT-23-5
U2: ESP32-C3; QFN-32-1EP_5x5mm_P0.5mm_EP3.45x3.45mm
Y1: Clock; Oscillator_SMD_SeikoEpson_SG8002LB-4Pin_5.0x3.2mm

Connections:
unnamed: -.1, AE1.1 (FEED), C1.2, C2.2, C3.2, C4.2, C5.2, C6.2, C7.2, C8.2, C9.2, C10.2, C11.2, C12.2, C13.2, C14.2, CR2032.2 (-), SW1.1, SW2.1, U1.2 (GND), U2.33 (GND), Y1.2 (GND)
unnamed: AE1.2 (PCB_Trace), C2.1, L1.1
unnamed: C1.1, L1.2, U2.1 (LNA_IN)
unnamed: C3.1, C5.1, CR2032.1 (+), D1.1 (K), U1.1 (VIN), U1.3 (ON/~OFF)
unnamed: C9.1, R4.2, SW2.2, U2.12 (MTCK/GPIO6)
unnamed: C10.1, R3.2, SW1.2, U2.9 (MTMS/GPIO4/ADC1_CH4)
unnamed: C4.1, C6.1, C7.1, C8.1, C11.1, C12.1, C13.1, C14.1, D1.2 (A), D2.1 (K), D3.1 (K), R1.1, R2.1, R3.1, R4.1, U1.5 (VOUT), U2.2 (VDD3P3), U2.3 (VDD3P3), U2.11 (VDD3P3_RTC), U2.17 (VDD3P3_CPU), U2.31 (VDDA), U2.32 (VDDA), Y1.1 (OE), Y1.4 (Vcc)
unnamed: D2.2 (A), R5.1
unnamed: D3.2 (A), R6.1
unnamed: R1.2, U2.7 (CHIP_EN)
unnamed: R2.2, U2.15 (GPIO9/BOOT)
unnamed: R5.2, U2.14 (GPIO8)
unnamed: R6.2, U2.16 (GPIO10)
unnamed: U2.4 (XTAL_32K_P/ADC1_CH0), Y1.3 (OUT)

Notes on the sheet:
GND Rail
LED2_K
GND
VBAT +
LED2_IO
VCC (3.0 V)
VCC Rail
LED1_K
LED1_IO
RC filter
VBAT -
BTN1_IO
BTN2_IO
VDD3P3
EN (HIGH)
VCC → LED
VDD3P3_CPU
VDDA
RF (50 Ω nominal)
VDD3P3_RTC
GPIO9 STRAP
