8-BitLab/safestep/hardware/Week 3/Schematics/Safestep.kicad_sch

## KiCad design hardware/Week 3/Schematics/Safestep.kicad_sch (2026-04-20)

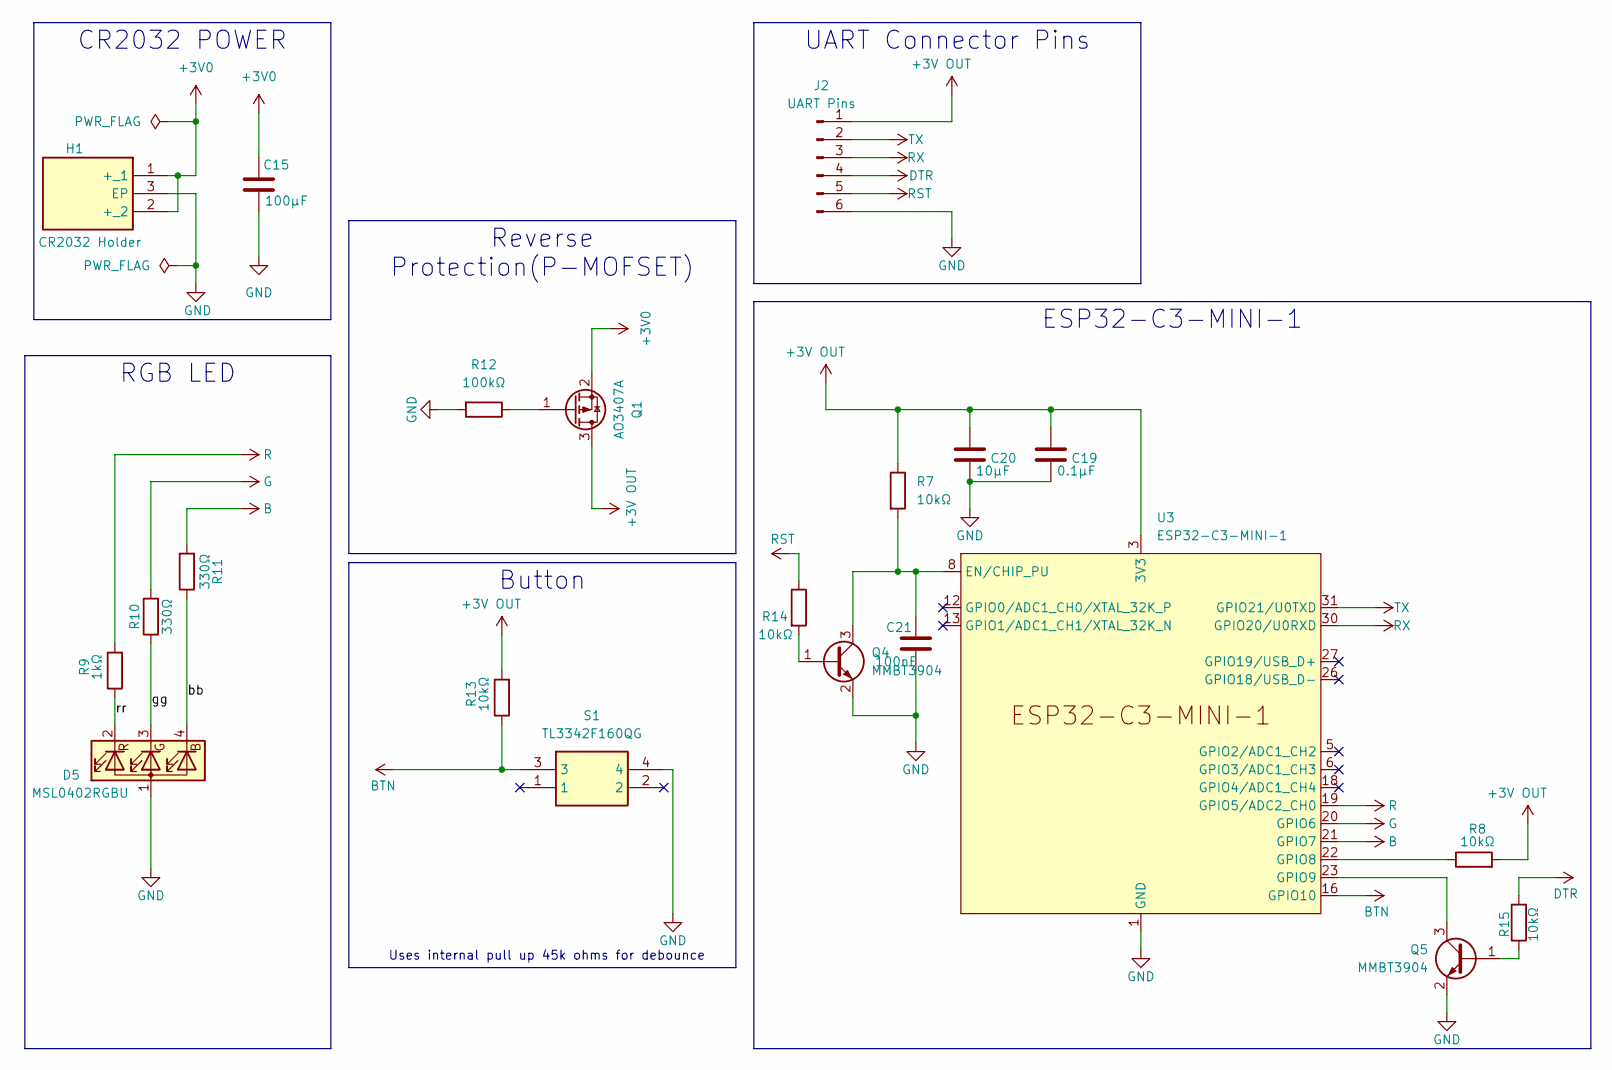
[picture p43: schematic Safestep.kicad_sch]

Parts:
C15: 100µF; C_01005_0402Metric
C19: 0.1μF; C_01005_0402Metric
C20: 10μF; C_01005_0402Metric
C21: 100nF; C_01005_0402Metric
D5: MSL0402RGBU; LED_RGB_1210
H1: CR2032 Holder; BATHLD003SMT; Mouser Part Number 712-BAT-HLD-003-SMT
J2: UART Pins; PinHeader_1x06_P1.00mm_Vertical
Q1: AO3407A; SOT-23
Q4, Q5: MMBT3904; SOT-23
R7, R13, R14, R15: 10kΩ; R_01005_0402Metric
R8: 10kΩ; R_0805_2012Metric
R9: 1kΩ; R_01005_0402Metric
R10, R11: 330Ω; R_01005_0402Metric
R12: 100kΩ; R_01005_0402Metric
S1: TL3342F160QG; Mouser Part Number 612-TL3342F160
U3: ESP32-C3-MINI-1

Connections:
+3V0: C15.1, H1.1 (+_1), H1.2 (+_2), Q1.2 (S)
+3V OUT: C19.1, C20.1, J2.1, Q1.3 (D), R7.1, R8.2, R13.2, U3.3 (3V3)
B: R11.2, U3.21 (GPIO7)
BTN: R13.1, S1.3, U3.16 (GPIO10)
DTR: J2.4, R15.2
G: R10.2, U3.20 (GPIO6)
GND: C15.2, C19.2, C20.2, C21.2, D5.1 (A), H1.3 (EP), J2.6, Q4.2 (E), Q5.2 (E), R12.2, S1.4, U3.1 (GND), U3.2 (GND), U3.11 (GND), U3.14 (GND), U3.36 (GND), U3.37 (GND), U3.38 (GND), U3.39 (GND), U3.40 (GND), U3.41 (GND), U3.42 (GND), U3.43 (GND), U3.44 (GND), U3.45 (GND), U3.46 (GND), U3.47 (GND), U3.48 (GND), U3.49 (GND), U3.50 (GND), U3.51 (GND), U3.52 (GND), U3.53 (GND)
unnamed: C21.1, Q4.3 (C), R7.2, U3.8 (EN/CHIP_PU)
unnamed: Q1.1 (G), R12.1
unnamed: Q4.1 (B), R14.2
unnamed: Q5.1 (B), R15.1
unnamed: Q5.3 (C), U3.23 (GPIO9)
unnamed: R8.1, U3.22 (GPIO8)
R: R9.2, U3.19 (GPIO5/ADC2_CH0)
RST: J2.5, R14.1
RX: J2.3, U3.30 (GPIO20/U0RXD)
TX: J2.2, U3.31 (GPIO21/U0TXD)
bb: D5.4 (BK), R11.1
gg: D5.3 (GK), R10.1
rr: D5.2 (RK), R9.1

Notes on the sheet:
Uses internal pull up 45k ohms for debounce
RGB LED
CR2032 POWER
ESP32-C3-MINI-1
UART Connector Pins
Button
Reverse Protection(P-MOFSET)
