8-BitLab/safestep/(commit log)

2026-04-13 Added basic receiver (+RSSI stats)
    [distance_rssi_table.csv]
2026-04-20 Week 3 HW Update
    [Safestep.kicad_sch, Schematics_v0.2.kicad_sch]
2026-05-02 Week 4 & 5 HW Update
    [SafestepHW.kicad_pcb, SafestepHW.kicad_sch]
2026-05-11 Week 6 HW Update
    [SafestepHW2.kicad_pcb, SafestepHW2.kicad_sch]
2026-05-17 Week 7 HW Update
    [SafestepHW2.kicad_pcb, SafestepHW2.kicad_sch]
